samam624/esp32-s3-pdm-audio-recorder/070926 Data/mic_damping_figures/04_spectra_grid.png

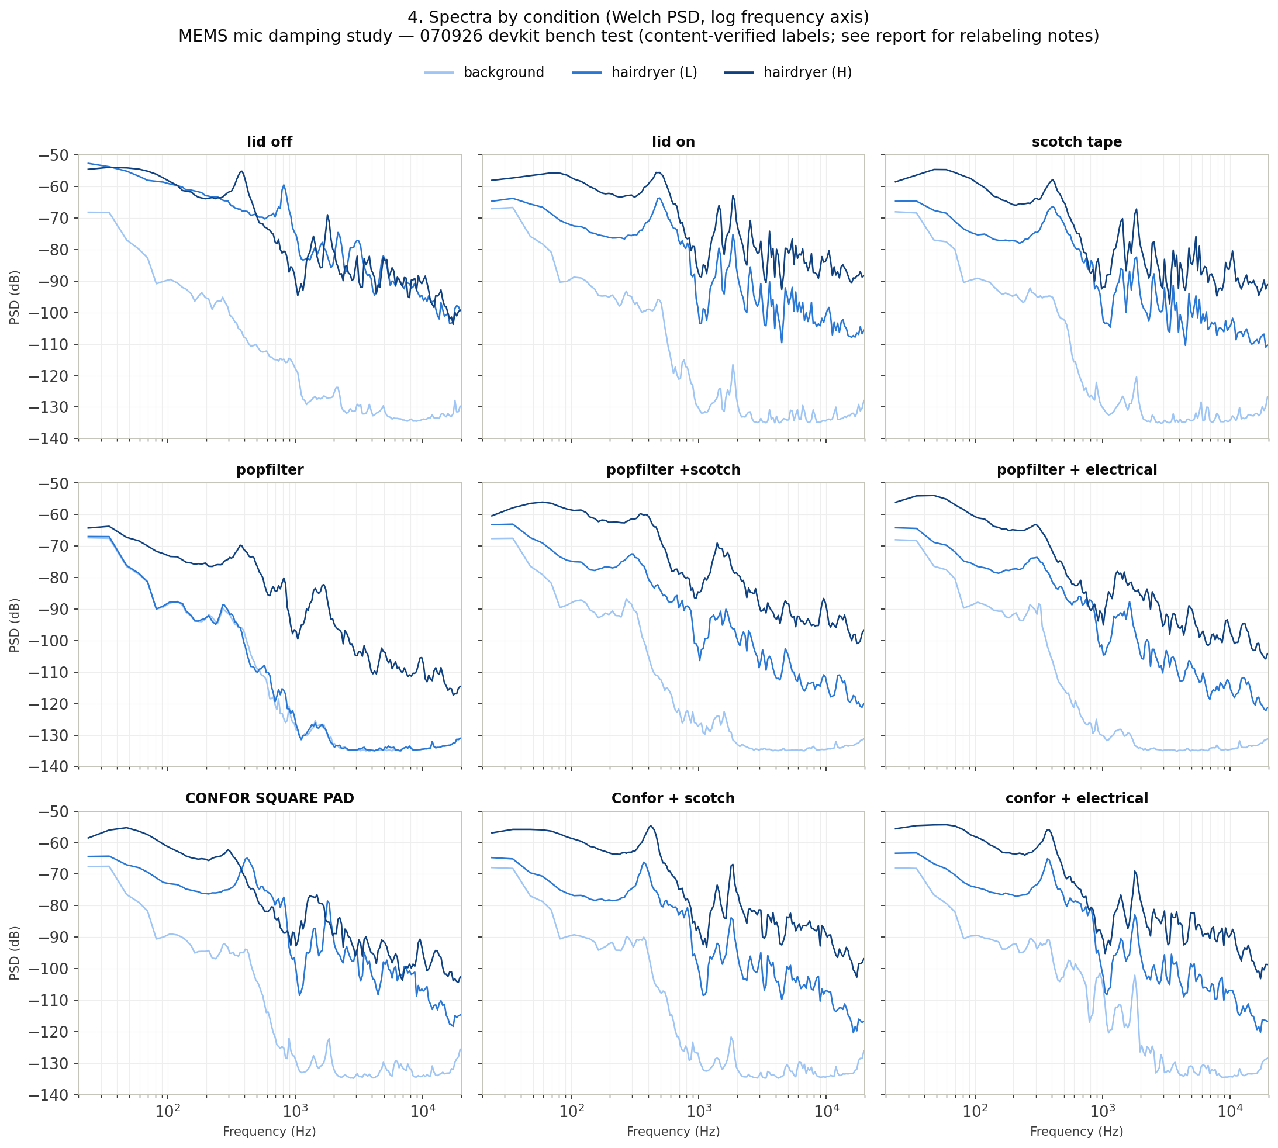
070926 Data/mic_damping_figures/04_spectra_grid.png
