samam624/esp32-s3-pdm-audio-recorder/070926 Data/mic_damping_figures/07_taped_vs_bare_diff.png

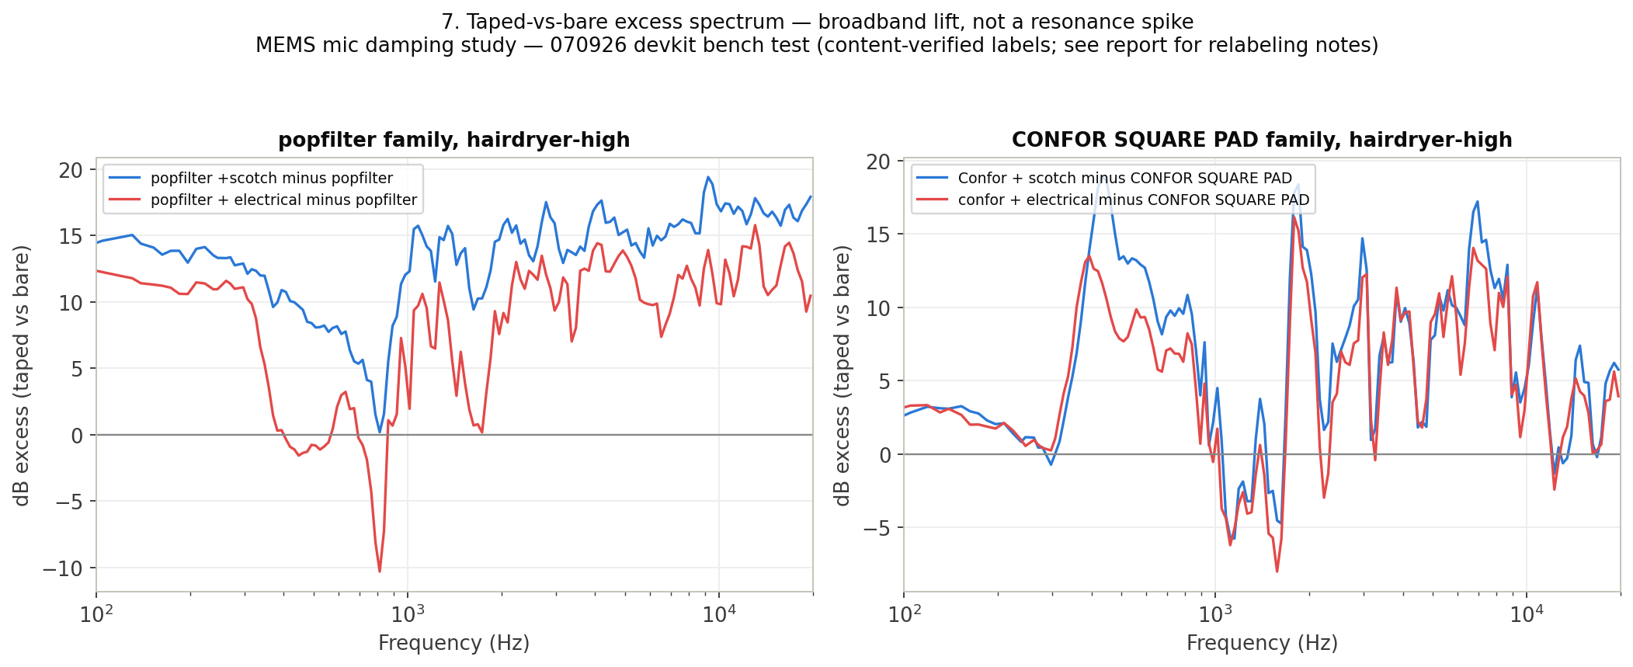
070926 Data/mic_damping_figures/07_taped_vs_bare_diff.png
