samam624/esp32-s3-pdm-audio-recorder/070926_Mic_Damping_Paper_Package/02_Figures/04_metrics_table.png

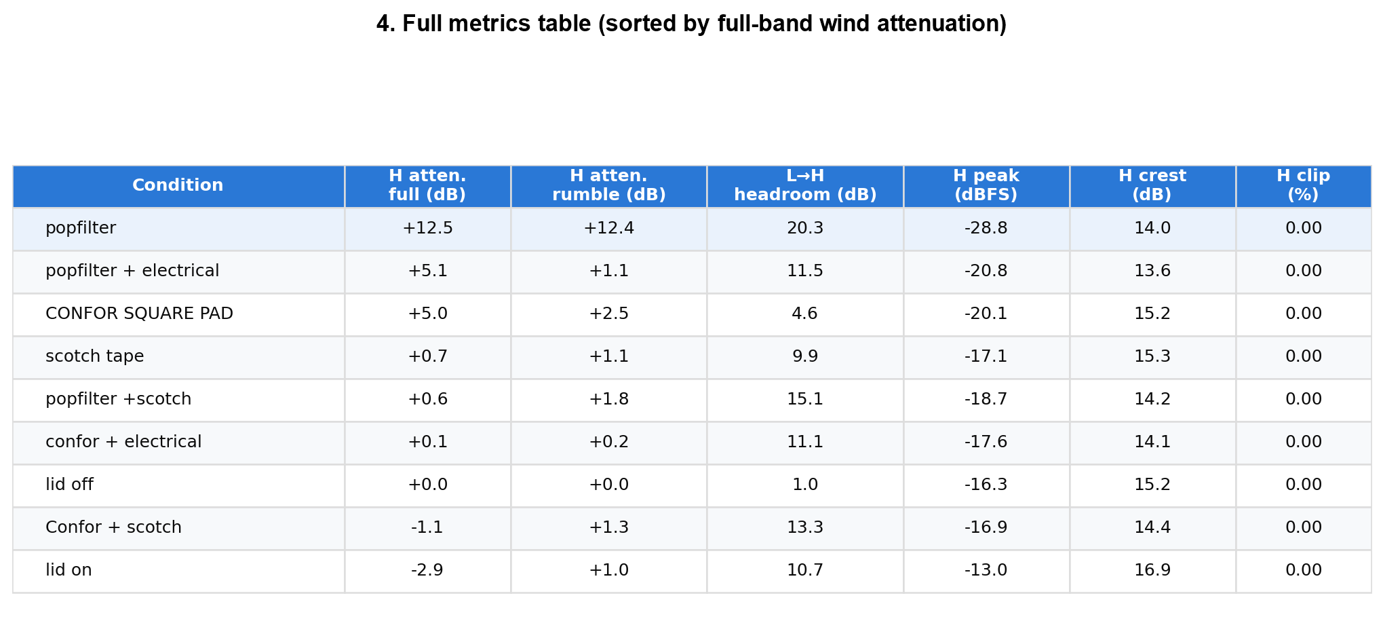
070926_Mic_Damping_Paper_Package/02_Figures/04_metrics_table.png
