samam624/esp32-s3-pdm-audio-recorder/MMSA V2/cad/wing_4415/output/reference/wing_ports.png

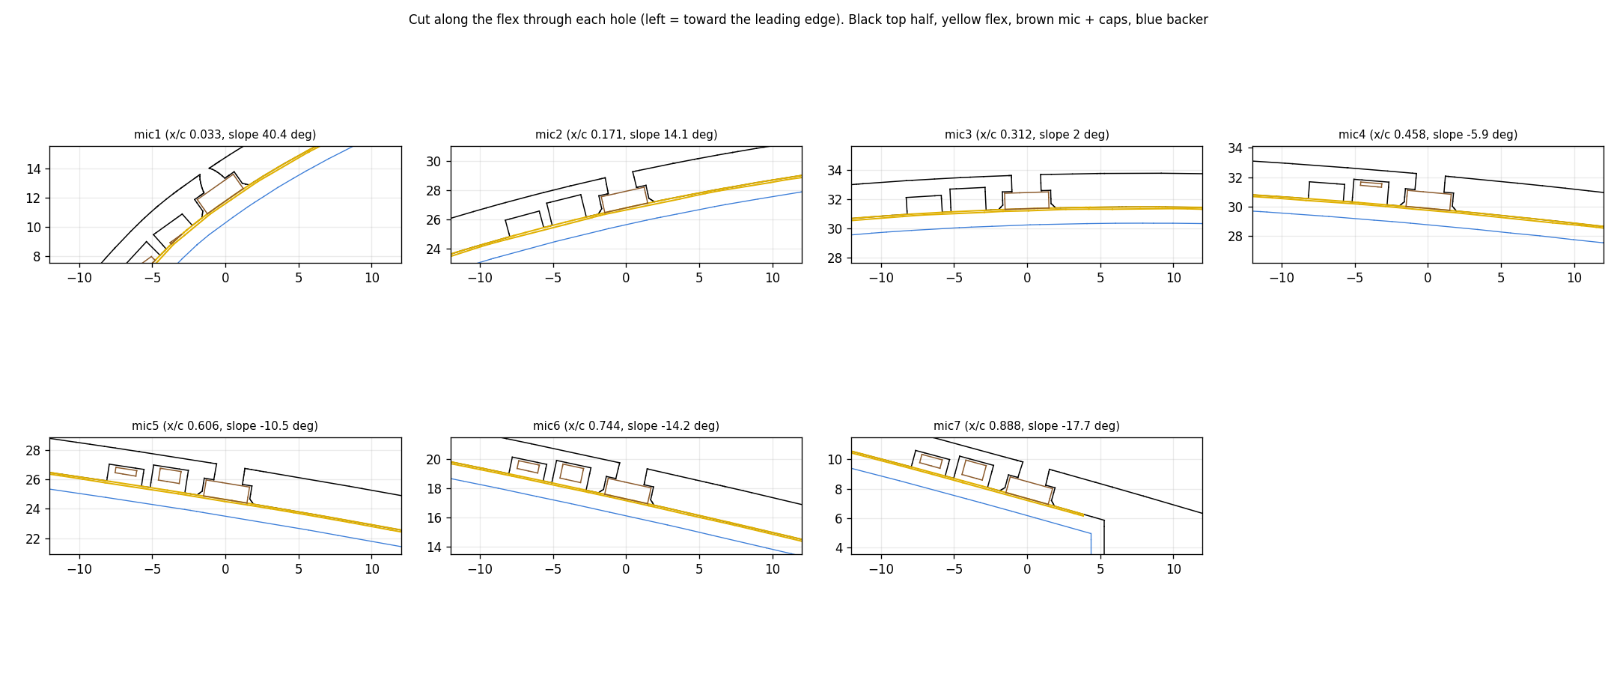
MMSA V2/cad/wing_4415/output/reference/wing_ports.png
