samam624/esp32-s3-pdm-audio-recorder/MMSA V2/data/102926/analysis/band_compare/paper_metrics_broadband.png

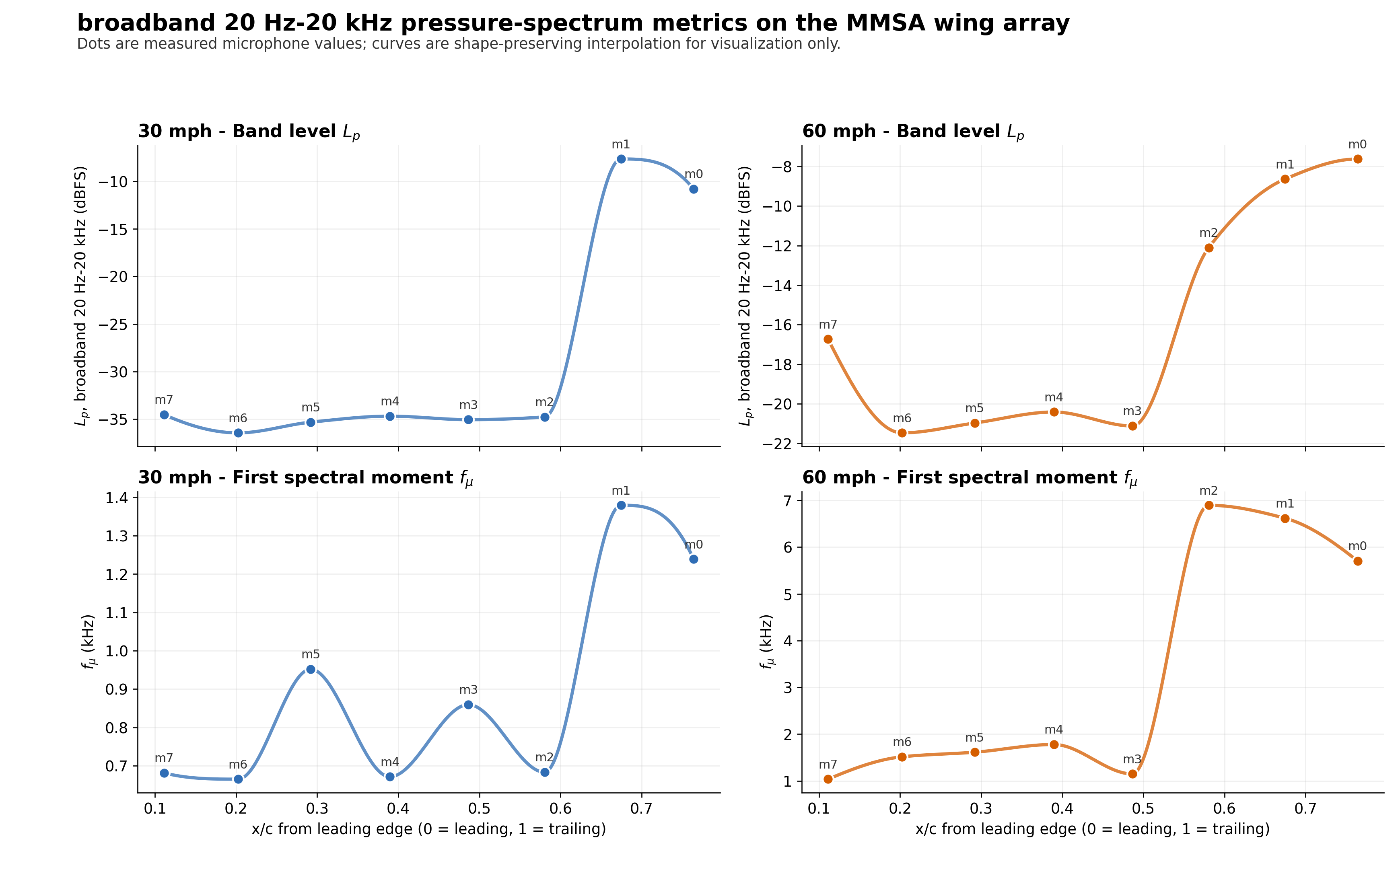
MMSA V2/data/102926/analysis/band_compare/paper_metrics_broadband.png
