samam624/esp32-s3-pdm-audio-recorder/MMSA V2/data/102926/analysis/baseline_spectrograms.png

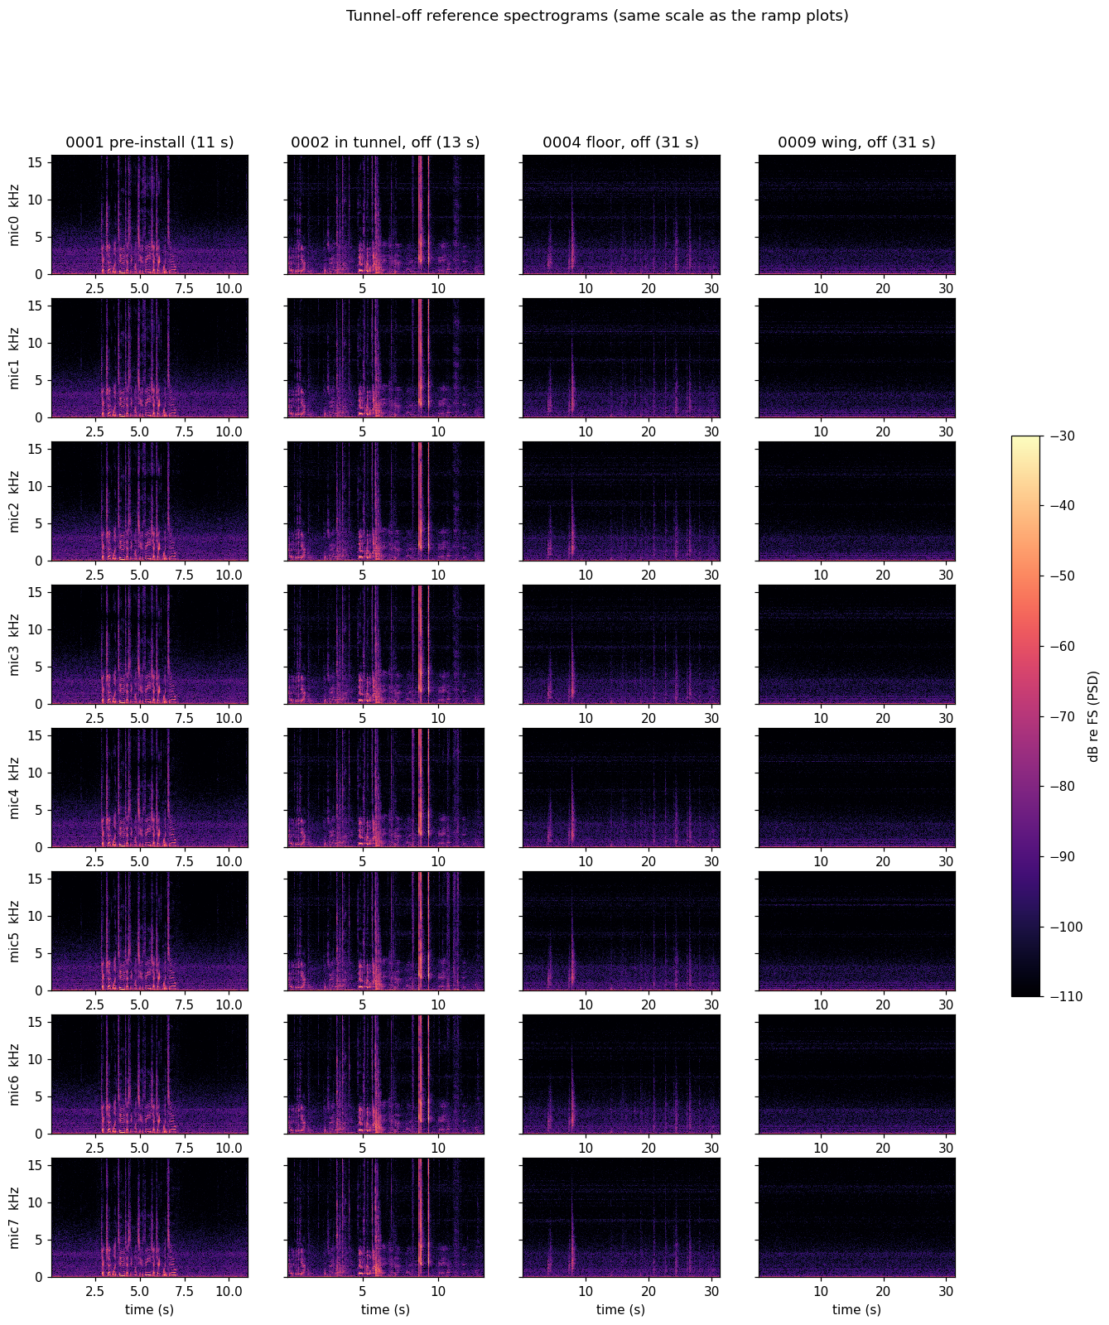
MMSA V2/data/102926/analysis/baseline_spectrograms.png
