samam624/esp32-s3-pdm-audio-recorder/MMSA V2/data/102926/analysis/flow_array_overlay_60mph.png

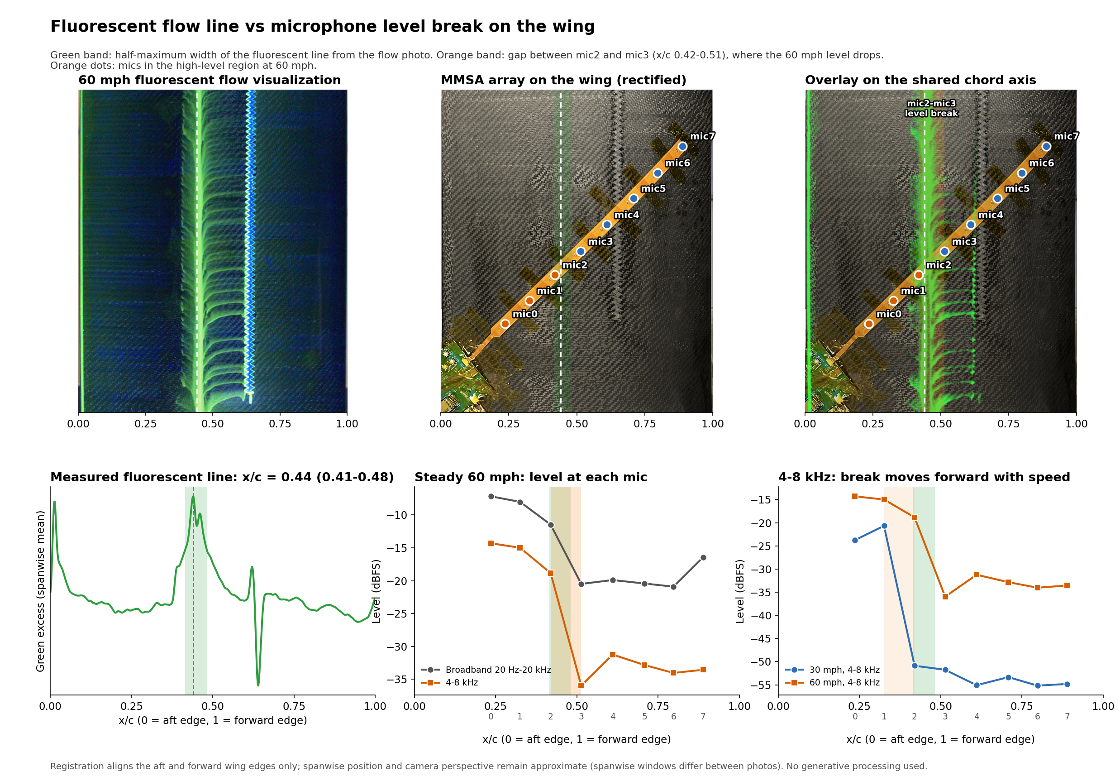
MMSA V2/data/102926/analysis/flow_array_overlay_60mph.png
