samam624/esp32-s3-pdm-audio-recorder/MMSA V2/data/102926/analysis/paper_methods/paper_metrics_spatial.png

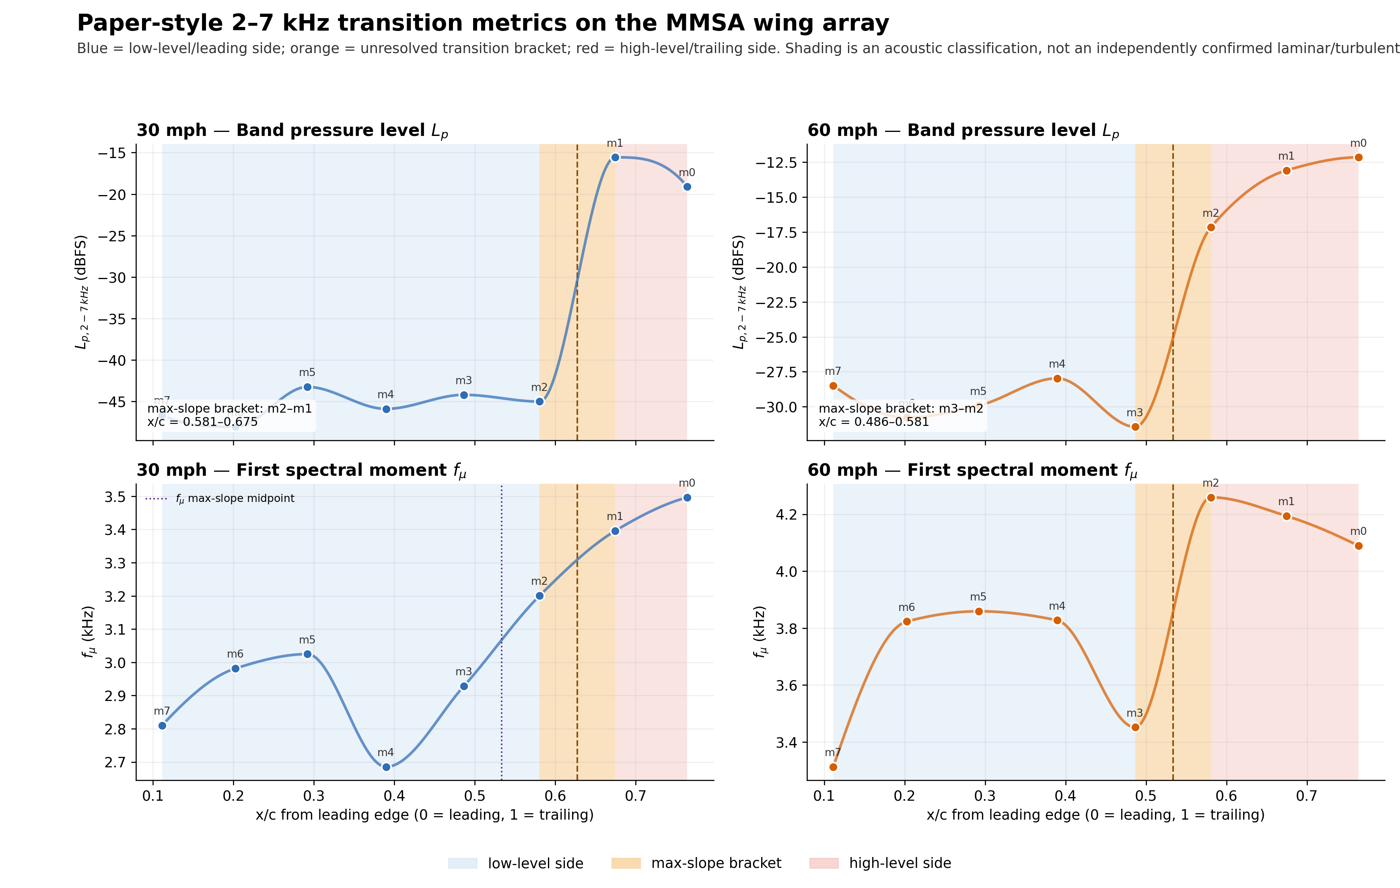
MMSA V2/data/102926/analysis/paper_methods/paper_metrics_spatial.png
