samam624/esp32-s3-pdm-audio-recorder/MMSA V2/data/102926/analysis/session_overview.png

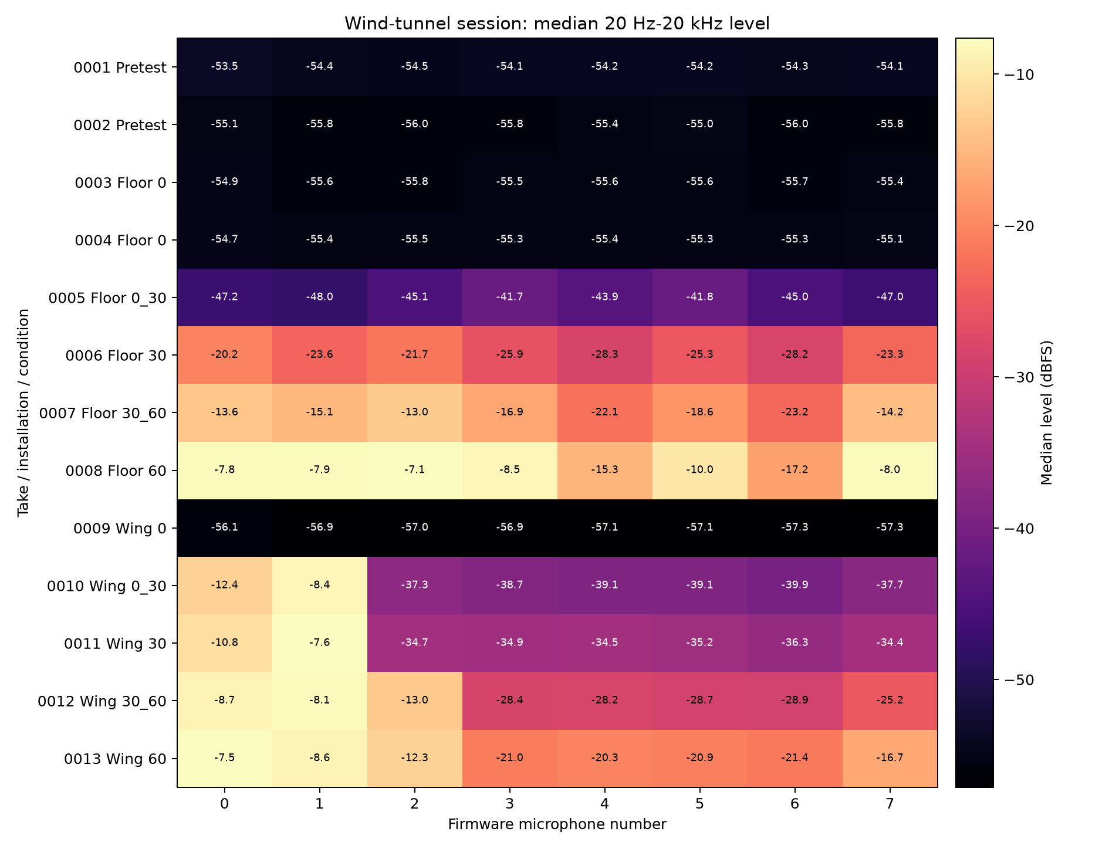
MMSA V2/data/102926/analysis/session_overview.png
