samam624/esp32-s3-pdm-audio-recorder/MMSA V2/data/102926/analysis/wing_peak_zone.png

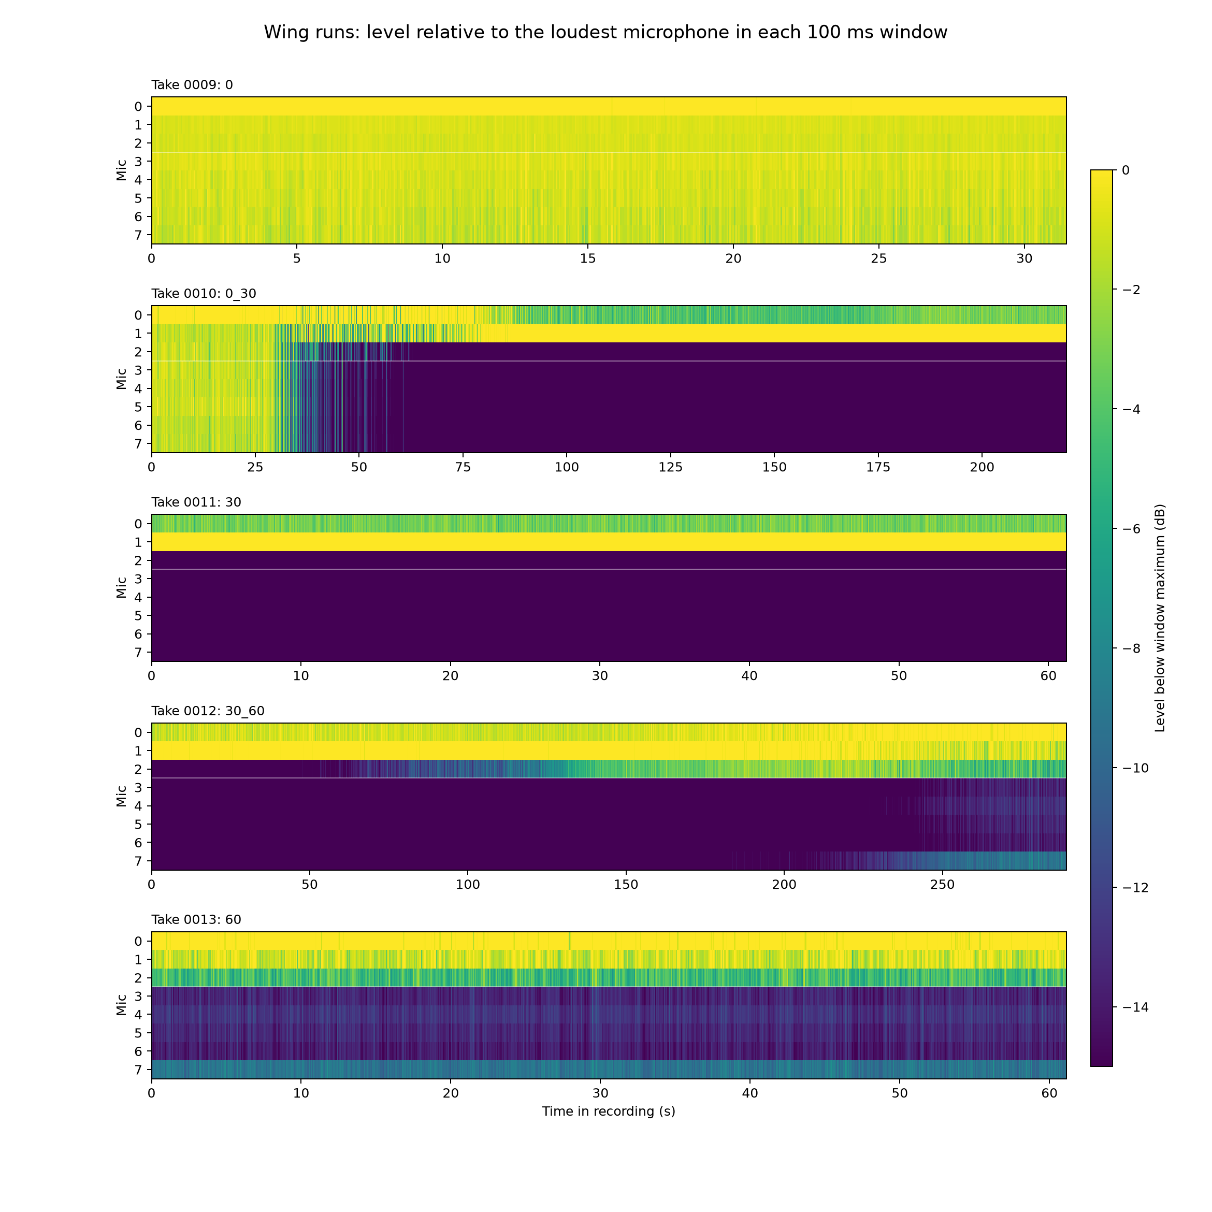
MMSA V2/data/102926/analysis/wing_peak_zone.png
