samam624/esp32-s3-pdm-audio-recorder/MMSA V2/data/102926/source_photos/flow_60mph.jpg

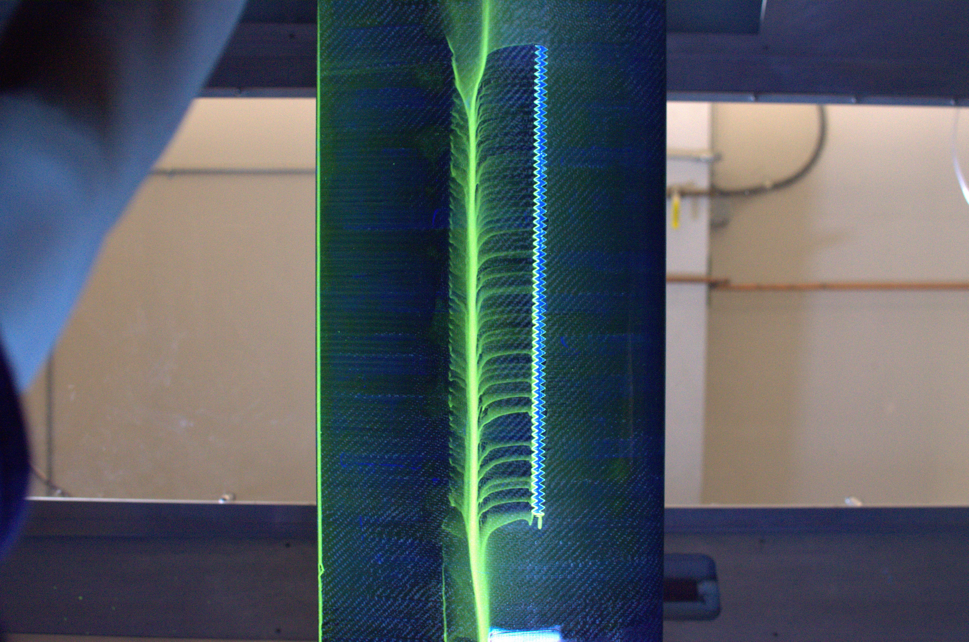
MMSA V2/data/102926/source_photos/flow_60mph.jpg
