samam624/esp32-s3-pdm-audio-recorder/MMSA V2/data/batlog/2026-10-26_charge/batlog_2026-10-26_charge.png

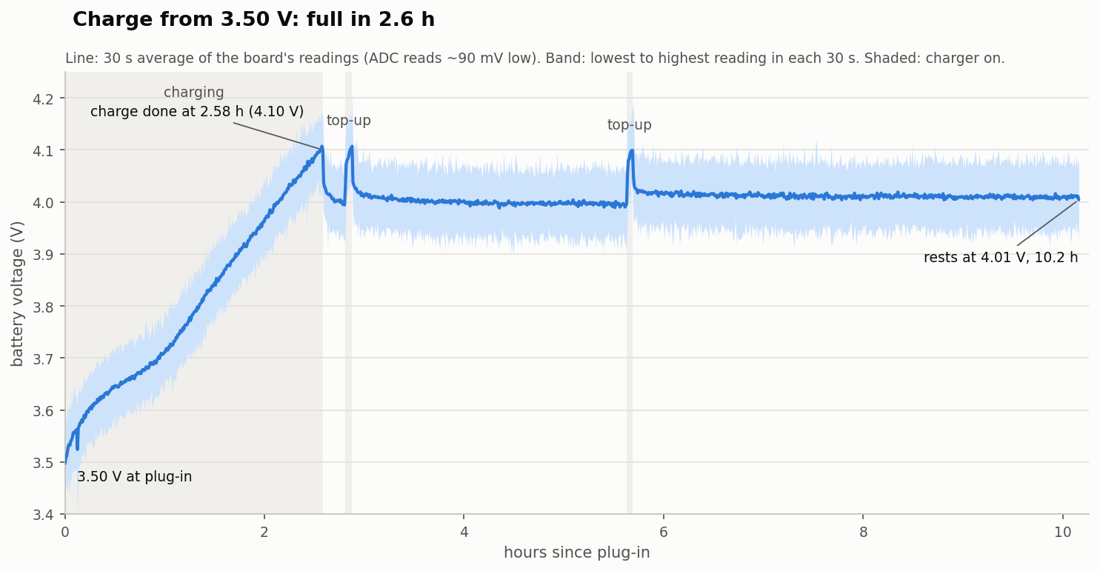
MMSA V2/data/batlog/2026-10-26_charge/batlog_2026-10-26_charge.png
