samam624/esp32-s3-pdm-audio-recorder/MMSA V2/data/power/2026-10-24/power_2026-10-24_vs_baseline.png

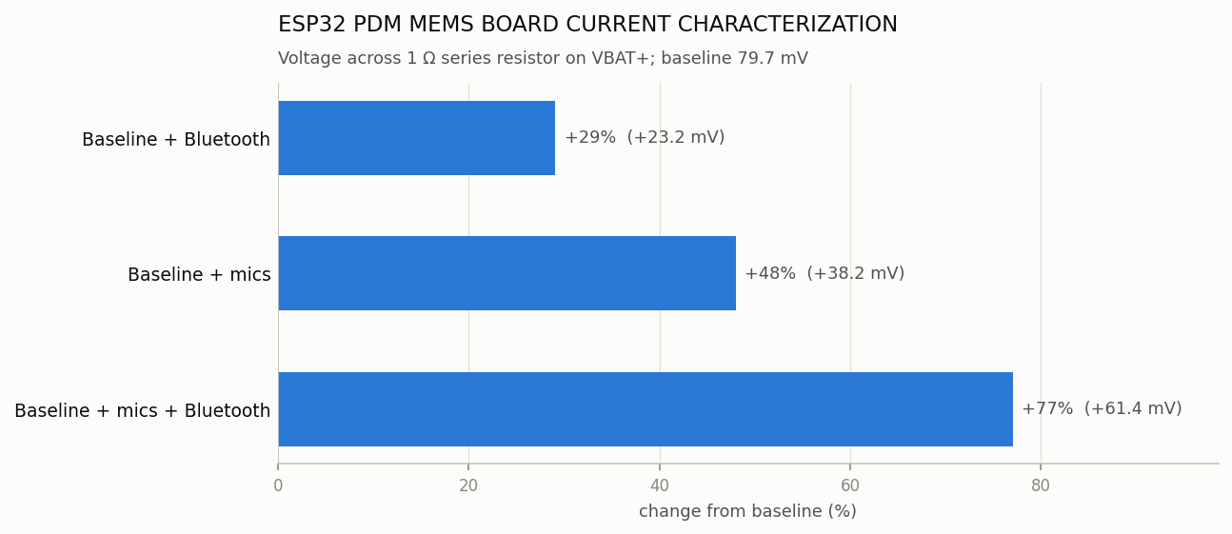
MMSA V2/data/power/2026-10-24/power_2026-10-24_vs_baseline.png
