samam624/esp32-s3-pdm-audio-recorder/MMSA V2/data/visualizations/window_comparison/gcc_100ms.png

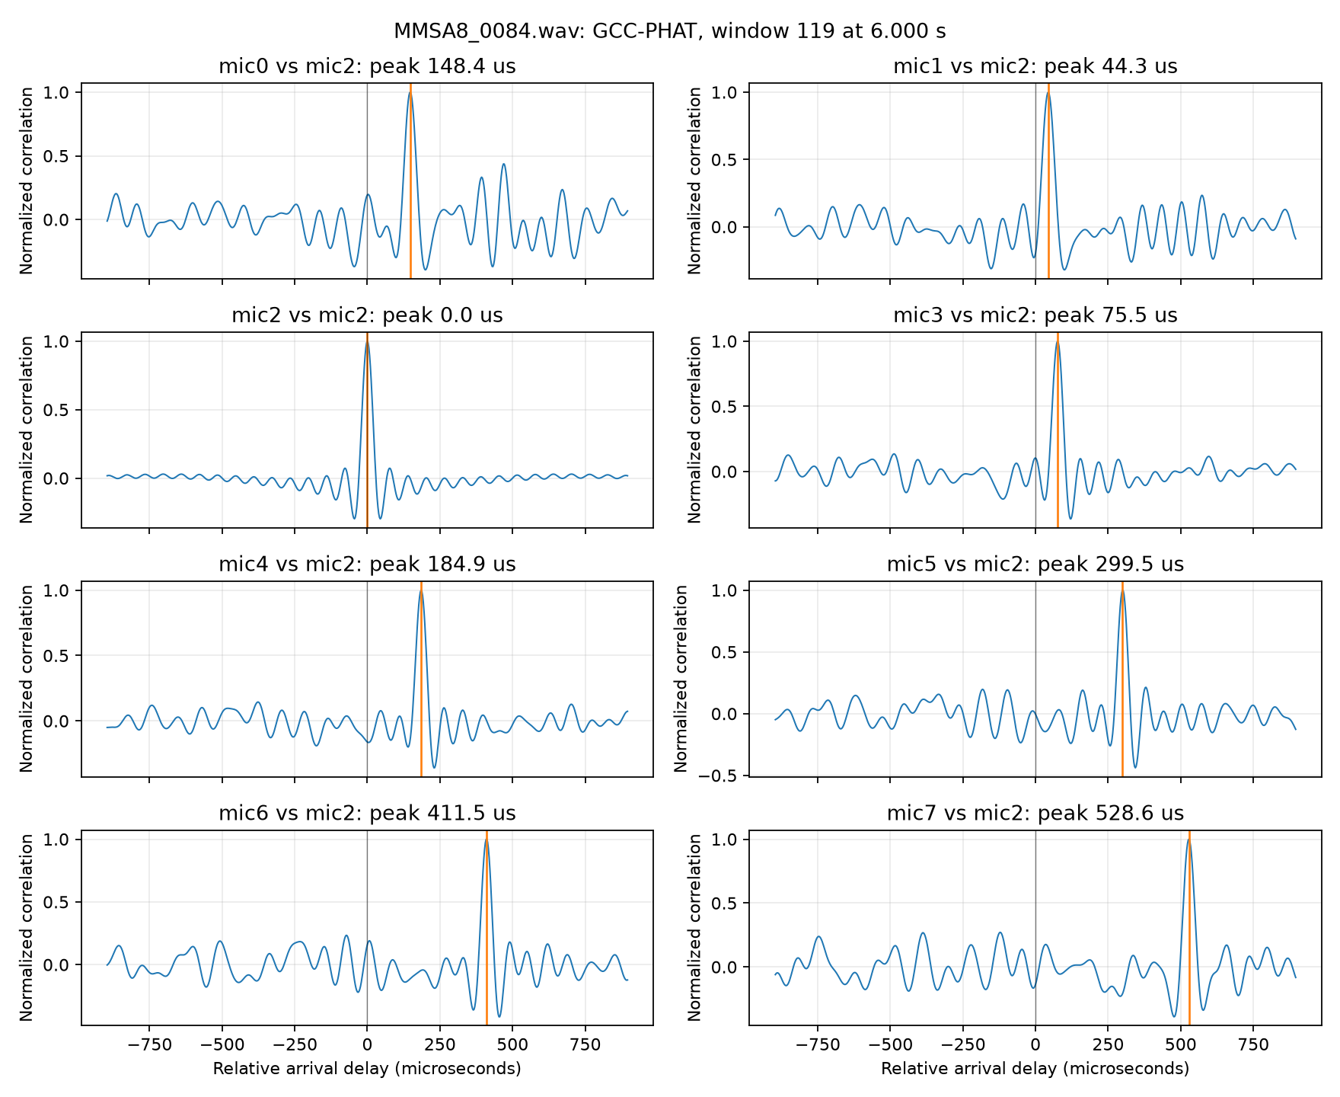
MMSA V2/data/visualizations/window_comparison/gcc_100ms.png
