samam624/esp32-s3-pdm-audio-recorder/MMSA V2/reference/port_filter_model.png

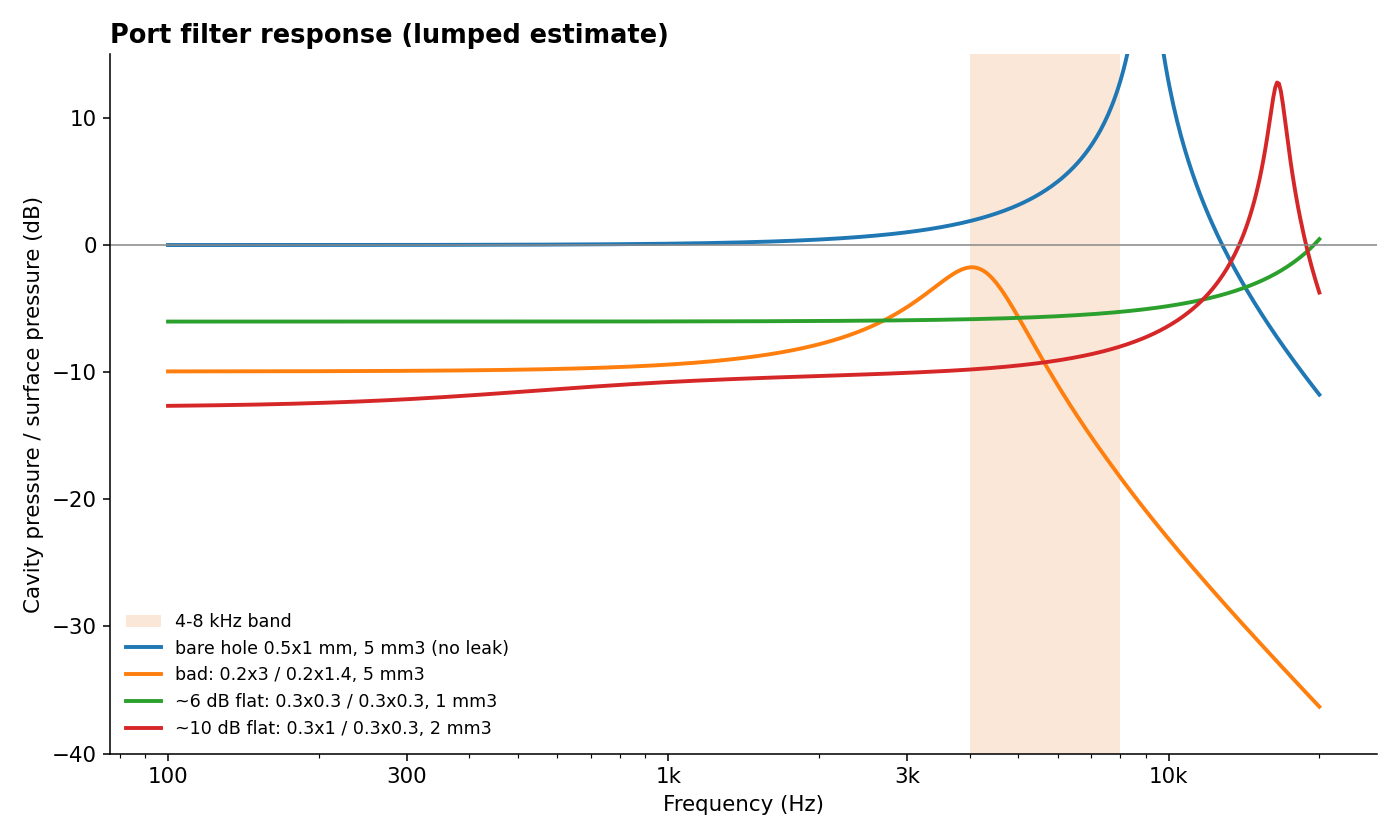
MMSA V2/reference/port_filter_model.png
