samam624/esp32-s3-pdm-audio-recorder/MMSA V2/reference/schematics/ESP32_SD_section.png

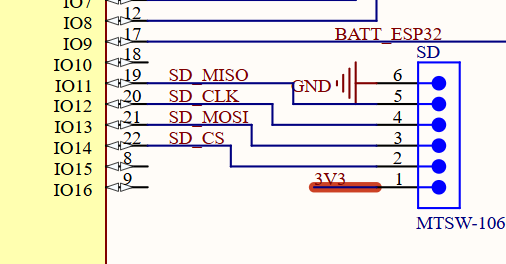
MMSA V2/reference/schematics/ESP32_SD_section.png
