samam624/esp32-s3-pdm-audio-recorder/MMSA V2/reference/schematics/FPC_connector_main_board.png

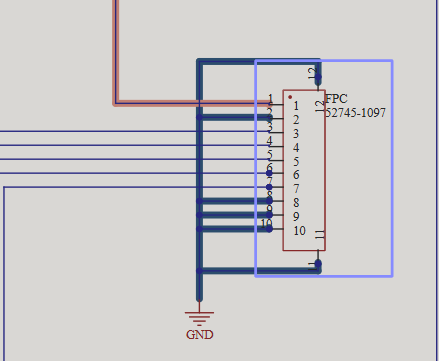
MMSA V2/reference/schematics/FPC_connector_main_board.png
