samam624/esp32-s3-pdm-audio-recorder/MMSA V2/reference/netlist/MMSA_V2_BOM_altium.csv

Line # | Name | Description | Designator | Revision ID | Revision State | Revision Status | Quantity | Manufacturer 1 | Manufacturer Part Number 1 | Manufacturer Lifecycle 1 | Supplier 1 | Supplier Part Number 1 | Supplier Unit Price 1 | Supplier Subtotal 1
 | B3F-1000 | Tactile Switch, SPST-NO, 0.05 A, 5 to 24 V, -25 to 70 degC, 4-Pin THD, RoHS, Bulk | BOOT, REC, RES | CMP-1677-00002-1 | Released | Up to date | 3 | Omron | B3F-1000 | Volume Production | Arrow Electronics | B3F-1000 | 0.2552 | 0.7656
 | CC0603MRX7R5BB475 | CAP CER 4.7UF 6.3V X7R 0603 | C1, C2 | CMP-03422-001038-2 | New From Design | Up to date | 2 | Yageo Group | CC0603MRX7R5BB475 | Volume Production | Mouser | 603-CC0603MRX75BB475 | 0.53 | 1.06
 | C0603C104Z3VACTU | CAP CER 0.1UF 25V Y5V 0603 | C3, C6, C12, C14, C15, C16, C17 | CMP-2006-03069-2 | Released | Up to date | 7 | Yageo Group | C0603C104Z3VACTU | Volume Production | RS (Formerly Allied Electronics) | C0603C104Z3VACTU | 0.02 | 0.14
 | CC0603KRX5R6BB106 | CAP CER 10UF 10V X5R 0603 | C4, C5, C7, C10, C11, C13 | CMP-03422-001507-1 | New From Design | Up to date | 6 | Yageo Group | CC0603KRX5R6BB106 | Volume Production | Newark | CC0603KRX5R6BB106 | 0.094 | 0.94
 | LTST-C190KGKT | LED GREEN CLEAR CHIP SMD | D1, D4 | CMP-2000-05197-2 | New From Design | Up to date | 2 | Diodes Inc. | LTST-C190KGKT | Volume Production | DigiKey | 160-1435-6-ND | 0.15 | 0.3
 | LTST-C190KFKT | LED ORANGE CLEAR CHIP SMD | D2 | CMP-1674-00008-9 | Released | Up to date | 1 | Diodes Inc. | LTST-C190KFKT | Volume Production | Arrow Electronics | LTST-C190KFKT | 0.0239 | 0.0478
 | LTST-C191TBKT | LED BLUE CLEAR CHIP SMD | D3 | CMP-22017-000008-1 | New From Design | Up to date | 1 | Diodes Inc. | LTST-C191TBKT | Volume Production | DigiKey | 160-1647-6-ND | 0.25 | 0.25
 | LTST-C190KRKT | LED RED CLEAR CHIP SMD | D5, D6 | CMP-1674-00011-2 | New From Design | Up to date | 2 | Diodes Inc. | LTST-C190KRKT | Volume Production | DigiKey | 160-1436-1-ND | 0.14 | 0.28
 | Test Point | Test Point | D-, D+ | CMP-00000-2 | Draft | Up to date | 2
 | USBLC6-2P6 | 17V Clamp 5A (8/20Âµs) Ipp Tvs Diode Surface Mount SOT-666 | ESD | CMP-025-000000-1 | Draft | Up to date | 1
 | ESP32-S3-WROOM-1-N8R8 | Bluetooth, WiFi 802.11b/g/n, Bluetooth v5.0 Transceiver Module 2.4GHz PCB Trace Surface Mount | ESP32_MC | CMP-009-000000-1 | Draft | Up to date | 1
 | MPZ1608D600BTD25 | Power line Ferrite Bead 60O @ 100MHz 1.2A DCR 0.1O AEC-Q200 SMD 0603 | FB | CMP-08257-000402-1 | New From Design | Up to date | 1 | TDK | MPZ1608D600BTD25 | Volume Production | Mouser | 810-MPZ1608D600BTD25 | 0.1 | 0.1
 | 687110183622 | Conn FFC/FPC Connector SKT 10 POS 0.5mm Solder RA SMD T/R | FPC | CMP-1502-01591-3 | Released | Up to date | 1 | Wurth Elektronik | 687110183622 | Volume Production | Mouser | 710-687110183622 | 1.84 | 1.84
 | TPS7A2018PDBVR | IC REG LINEAR 1.8V 300MA SOT23-5 | LDO_1V8 | CMP-04917-000324-1 | New From Design | Up to date | 1 | Texas Instruments | TPS7A2018PDBVR | Volume Production | DigiKey | 296-TPS7A2018PDBVRDKR-ND | 0.37 | 0.37
 | AP2112K-3.3TRG1 | IC REG LINEAR 3.3V 600MA SOT25 | LDO_3V3 | CMP-12756-000035-1 | New From Design | Up to date | 1 | Diodes Inc. | AP2112K-3.3TRG1 | Volume Production | Mouser | 621-AP2112K-3.3TRG1 | 0.26 | 0.26
 | S2B-PH-K-S(LF)(SN) | Male Header, Pitch 2 mm, 1 x 2 Position, Height 4.8 mm, Tail Length 3.4 mm, -25 to 85 degC, RoHS, Bulk | LiPo | CMP-1755-00004-1 | Released | Up to date | 1 | JST | S2B-PH-K-S(LF)(SN) | Volume Production | Mouser | 306-S2BPHKSLFSNPP | 0.11 | 0.11
 | RC0603FR-132KL |  | R1 | CMP-2000-04213-1 | Released | Up to date | 1 | Yageo Group | RC0603FR-132KL | Volume Production | Mouser | 603-RC0603FR-132KL | 0.1 | 0.1
 | CPF0603D10KE | RES SMD 10KO 0.5% 1/16W 0603 | R2, R3, R9, R11, R13 | CMP-03211-003506-1 | New From Design | Up to date | 5 | TE Connectivity / AMP | 2-1614882-6 | Volume Production | Mouser | 279-CPF0603D10KE | 0.1 | 0.5
 | RC0603JR-13470RL |  | R4, R5, R6, R17, R18, R19 | CMP-2000-04326-1 | Released | Up to date | 6 | Yageo Group | RC0603JR-13470RL | Volume Production | Mouser | 603-RC0603JR-13470RL | 0.012 | 0.12
 | CRCW06035K10JNEA | RES Thick Film, 5.1kO, 5%, 0.1W, 200ppm/°C, 0603 | R7, R8 | CMP-2000-03480-2 | New From Design | Up to date | 2 | Vishay | CRCW06035K10JNEA | Volume Production | Arrow Electronics | CRCW06035K10JNEA | 0.0009 | 0.0018
 | RC0603JR-0722RL | RES SMD 22 OHM 5% 1/10W 0603 | R10, R15, R16 | CMP-03412-037819-1 | New From Design | Up to date | 3 | Yageo Group | RC0603JR-0722RL | Volume Production | Mouser | 603-RC0603JR-0722RL | 0.012 | 0.12
 | CRGP0603F100K | CRGP 0603 100K 1% | R12, R14 | CMP-03211-000885-1 | New From Design | Up to date | 2 | TE Connectivity | CRGP0603F100K | Volume Production | Newark | CRGP0603F100K | 0.173 | 0.346
 | MTSW-106-09-T-S-540 | Modified .025" SQ Post Header, Through-hole, Vertical, -55 to 105 degC, 2.54 mm Pitch, 6-Pin, Male, RoHS | SD | CMP-1024-00125-1 | Released | Up to date | 1 | Samtec | MTSW-106-09-T-S-540 | Volume Production | Avnet | MTSW-106-09-T-S-540 | 0.396 | 0.396
 | MCP73871T-4CCI/ML | Stand-Alone System Load Sharing and Li-Ion/Li-Polymer Battery Charge Management Controller, 4.4V, 20-Pin QFN, Industrial Temperature, Tape and Reel | USB_IC | CMP-0133-00010-1 | Released | Up to date | 1 | Microchip | MCP73871T-4CCI/ML | Volume Production | DigiKey | MCP73871T-4CCI/MLCT-ND | 2.41 | 2.41
 | 10155435-00011LF |  | USBC | CMP-017-000000-1 | Draft | Up to date | 1
