samam624/esp32-s3-pdm-audio-recorder/MMSA V2/reference/netlist/MMSA_V2_BOM_JLCPCB.csv

Comment | Designator | Footprint | LCSC Part #
MCP73871T-2CCI/ML | Charging IC | QFN-20-EP(4x4) | C511310
B3F-1000 | BOOT,REC,RES | THD 4-Pin | C93157
CC0603KRX7R9BB104 | C3,C6,C12,C14,C15,C16,C17 | 0603 | C14663
CL10A106KP8NNNC | C4,C5,C7,C10,C11,C13 | 0603 | C19702
CL10A475KA8NQNC | C1,C2 | 0603 | C69335
LTST-C190KGKT | D1,D3,D4 | 0603 | C125094
LTST-C190KRKT | D2,D5,D6 | 0603 | C94869
USBLC6-2P6 | ESD1 | SOT-666-6 | C15999
ESP32-S3-WROOM-1-N8R8 | ESP32_MC | SMD,18x13mm | C2913201
MPZ1608D600BTD25 | FB | 0603 | C404683
687110183622 | FPC | FPC SMT ZIF, 10-pos, 0.5mm pitch, Top Contact
TPS7A2018PDBVR | LDO_1V8 | SOT-23-5 | C963430
AP2112K-3.3TRG1 | LDO_3V3 | SOT-25 | C51118
S2B-PH-K-S(LF)(SN) | LiPo | THD 2-Pin Right Angle | C173752
0603WAF2001T5E | R1 | 0603 | C269690
0603WAF1002T5E | R2,R3,R9,R11,R13 | 0603 | C25804
RC0603FR-07470RL | R4,R5,R6,R17,R18,R19 | 0603 | C114669
0603WAF5101T5E | R7,R8 | 0603 | C23186
RC0603FR-0722RL | R10,R15,R16 | 0603 | C107701
0603 100K 1% | R12,R14 | 0603 | C2889376
10155435-00011LF | USBC | USB-C SMD Receptacle
