samam624/esp32-s3-pdm-audio-recorder/MMSA V2/cad/airfoil_testbed/output/MMSA_testbed_v1_print.3mf

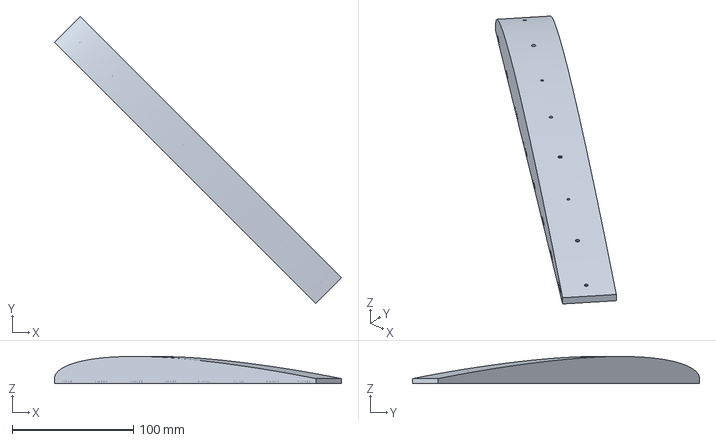
[picture p66: CAD file, 2026-11-03]
MMSA V2/cad/airfoil_testbed/output/MMSA_testbed_v1_print.3mf
236.7 x 236.7 x 22.3 mm
