samam624/esp32-s3-pdm-audio-recorder/MMSA V2/cad/airfoil_testbed/output/reference/MMSA_testbed_v1_backer_only.3mf

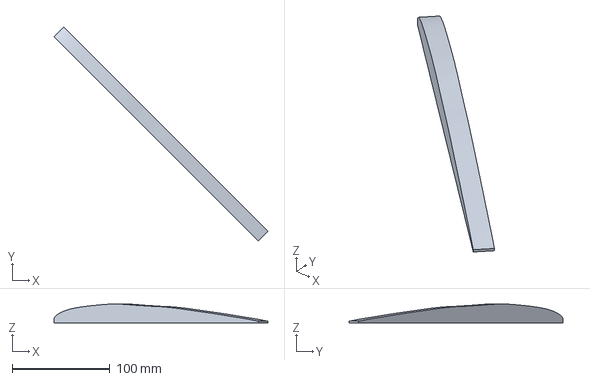
[picture p67: CAD file, 2026-11-03]
MMSA V2/cad/airfoil_testbed/output/reference/MMSA_testbed_v1_backer_only.3mf
218.8 x 218.8 x 19.2 mm
