samam624/esp32-s3-pdm-audio-recorder/MMSA V2/cad/airfoil_testbed_0012/output/reference/backer.stl

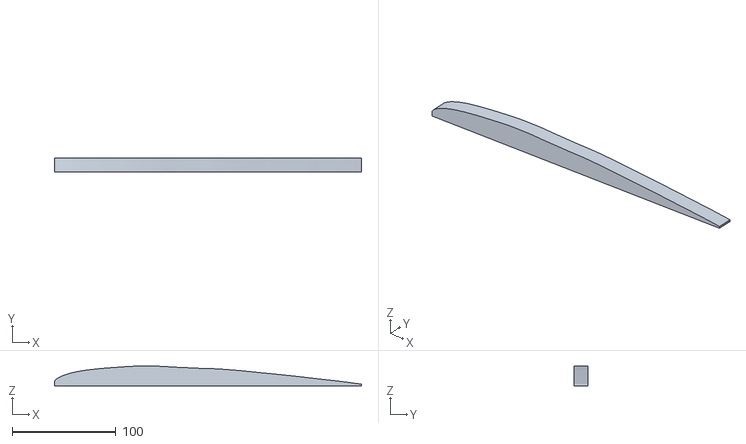
[picture p68: CAD file, 2026-11-03]
MMSA V2/cad/airfoil_testbed_0012/output/reference/backer.stl
295.6 x 13.8 x 19.2
