samam624/esp32-s3-pdm-audio-recorder/MMSA V2/cad/airfoil_testbed_4415/input/Air Foil NACA 4415 Small Slot.step

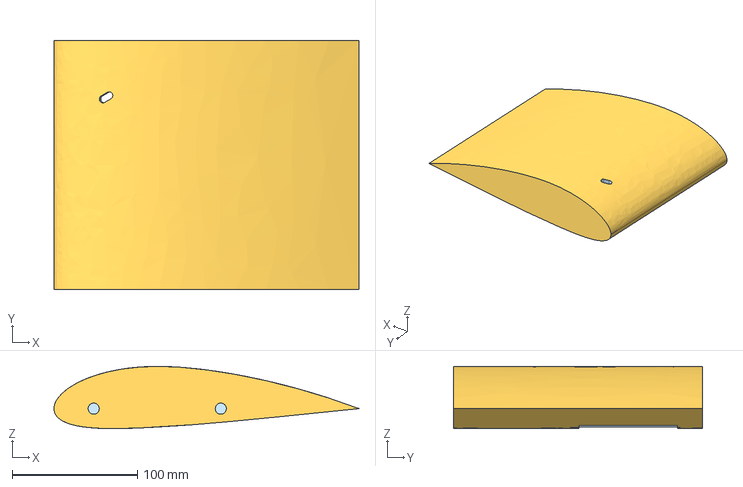
[picture p69: CAD file, 2026-11-03]
MMSA V2/cad/airfoil_testbed_4415/input/Air Foil NACA 4415 Small Slot.step
243.8 x 199.1 x 49.8 mm
