samam624/esp32-s3-pdm-audio-recorder/MMSA V2/cad/airfoil_testbed_4415/output/MMSA_testbed_4415_print.3mf

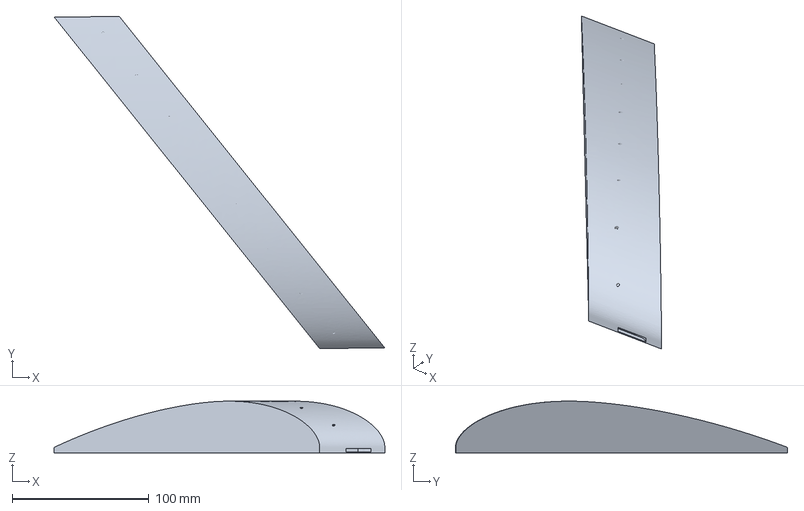
[picture p70: CAD file, 2026-11-03]
MMSA V2/cad/airfoil_testbed_4415/output/MMSA_testbed_4415_print.3mf
241.6 x 242.6 x 37.8 mm
