samam624/esp32-s3-pdm-audio-recorder/MMSA V2/cad/airfoil_testbed_4415/output/reference/MMSA_testbed_4415_fitcheck.step

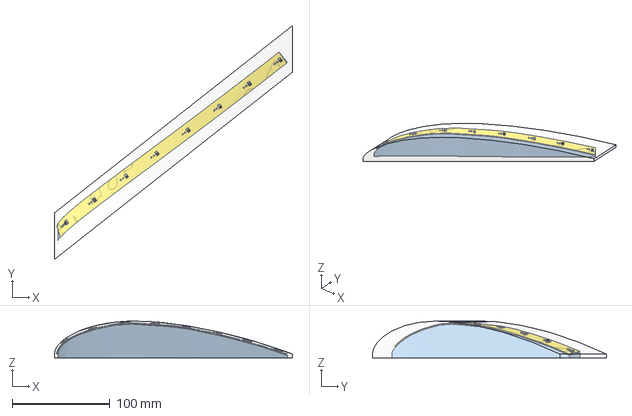
[picture p71: CAD file, 2026-11-03]
MMSA V2/cad/airfoil_testbed_4415/output/reference/MMSA_testbed_4415_fitcheck.step
243.8 x 239.5 x 37.8 mm
