samam624/esp32-s3-pdm-audio-recorder/MMSA V2/cad/wing_4415/output/reference/MMSA_wing_4415_fitcheck.step

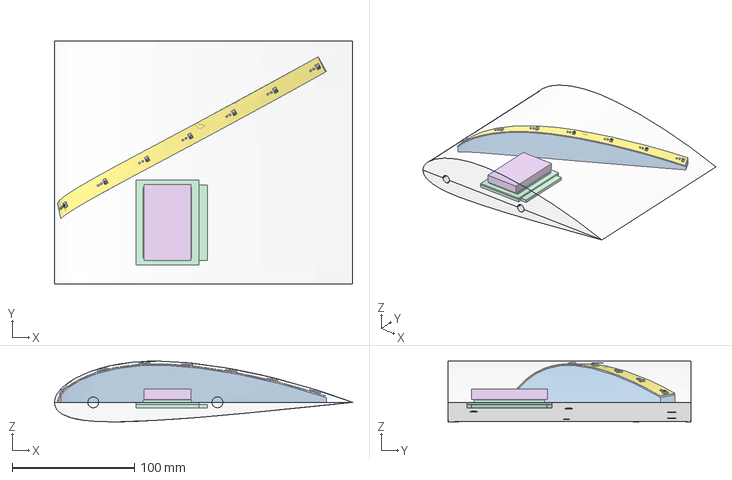
[picture p73: CAD file, 2026-11-03]
MMSA V2/cad/wing_4415/output/reference/MMSA_wing_4415_fitcheck.step
243.8 x 199.1 x 49.8 mm
