samam624/esp32-s3-pdm-audio-recorder/MMSA V2/cad/airfoil_testbed/output/MMSA_testbed_v1.step

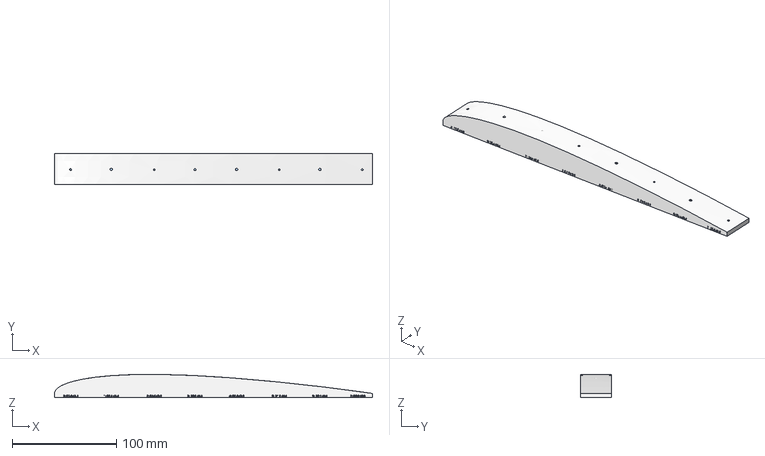
[picture p74: CAD file, 2026-11-03]
MMSA V2/cad/airfoil_testbed/output/MMSA_testbed_v1.step
304.8 x 30.0 x 22.3 mm
