samam624/esp32-s3-pdm-audio-recorder/MMSA V2/cad/airfoil_testbed/output/reference/block.stl

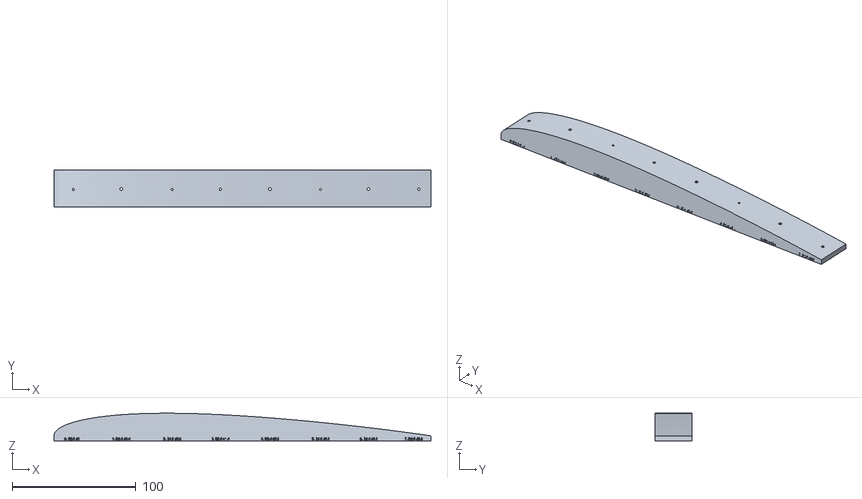
[picture p75: CAD file, 2026-11-03]
MMSA V2/cad/airfoil_testbed/output/reference/block.stl
304.8 x 30.0 x 22.3
