samam624/esp32-s3-pdm-audio-recorder/MMSA V2/cad/airfoil_testbed_0012/output/reference/MMSA_testbed_0012_fitcheck.step

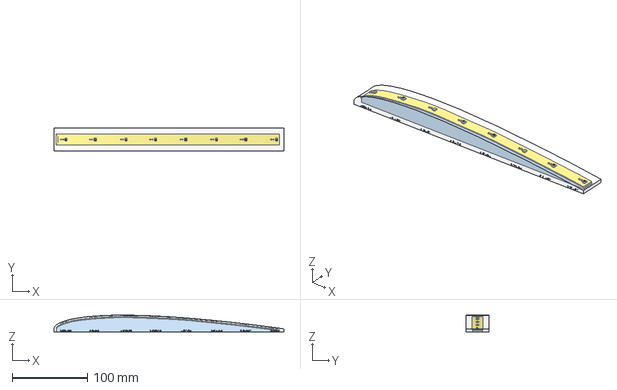
[picture p76: CAD file, 2026-11-03]
MMSA V2/cad/airfoil_testbed_0012/output/reference/MMSA_testbed_0012_fitcheck.step
304.8 x 30.0 x 22.3 mm
