samam624/esp32-s3-pdm-audio-recorder/MMSA V2/cad/airfoil_testbed_4415/output/reference/backer.stl

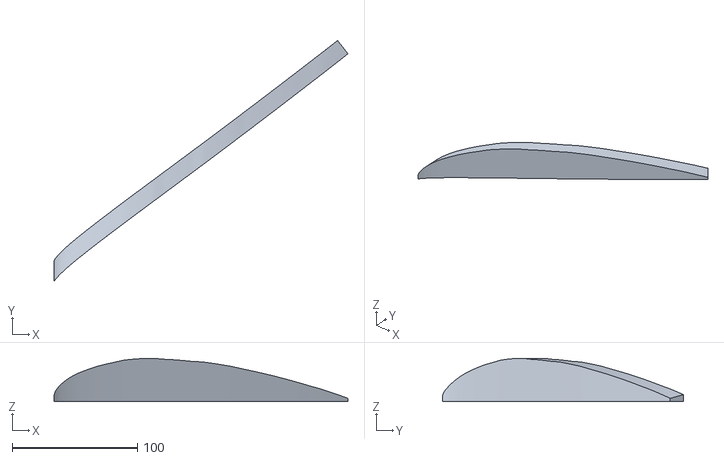
[picture p77: CAD file, 2026-11-03]
MMSA V2/cad/airfoil_testbed_4415/output/reference/backer.stl
235.1 x 192.7 x 34.7
