samam624/esp32-s3-pdm-audio-recorder/MMSA V2/cad/wing_4415/output/MMSA_wing_4415_top_print.3mf

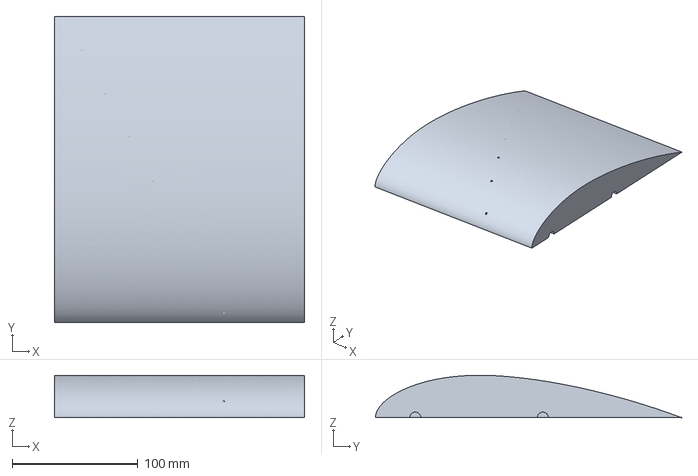
[picture p78: CAD file, 2026-11-03]
MMSA V2/cad/wing_4415/output/MMSA_wing_4415_top_print.3mf
199.1 x 243.8 x 33.8 mm
