samam624/esp32-s3-pdm-audio-recorder/MMSA V2/cad/wing_4415/output/reference/top.stl

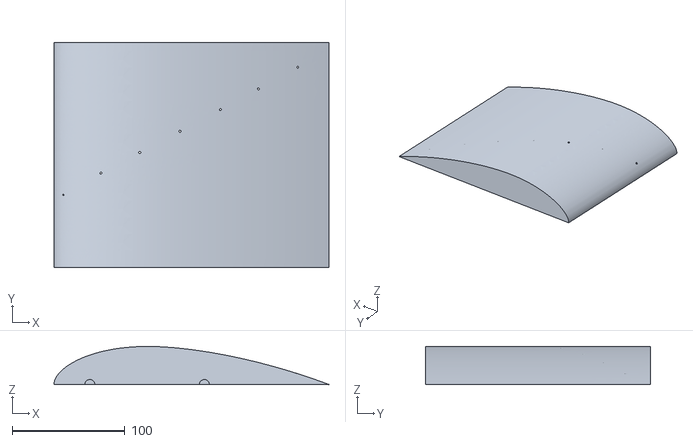
[picture p79: CAD file, 2026-11-03]
MMSA V2/cad/wing_4415/output/reference/top.stl
243.8 x 199.1 x 33.8
