samam624/esp32-s3-pdm-audio-recorder/MMSA V2/cad/airfoil_testbed_0012/output/reference/flex.stl

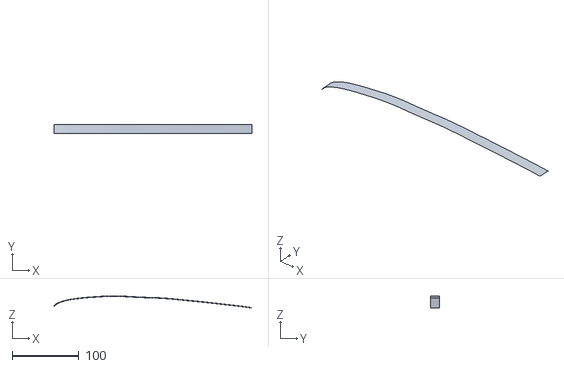
[picture p80: CAD file, 2026-11-03]
MMSA V2/cad/airfoil_testbed_0012/output/reference/flex.stl
296.2 x 14.0 x 17.5
