samam624/esp32-s3-pdm-audio-recorder/MMSA V2/cad/airfoil_testbed_4415/output/reference/flex.stl

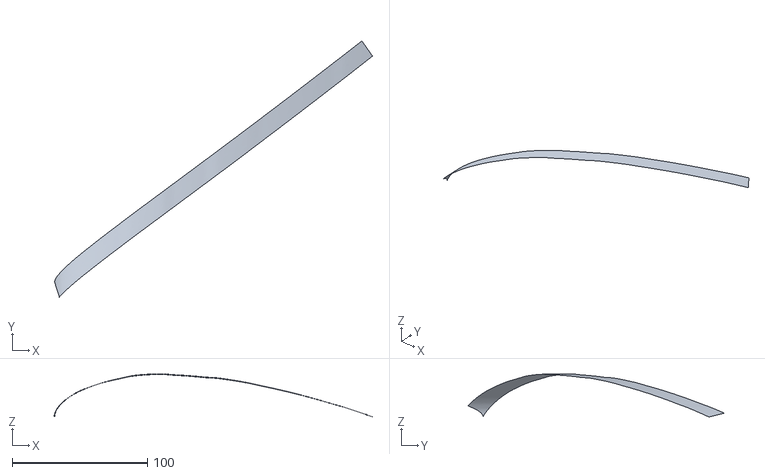
[picture p81: CAD file, 2026-11-03]
MMSA V2/cad/airfoil_testbed_4415/output/reference/flex.stl
235.5 x 189.7 x 31.8
