samam624/esp32-s3-pdm-audio-recorder/MMSA V2/cad/airfoil_testbed_0012/output/reference/parts.stl

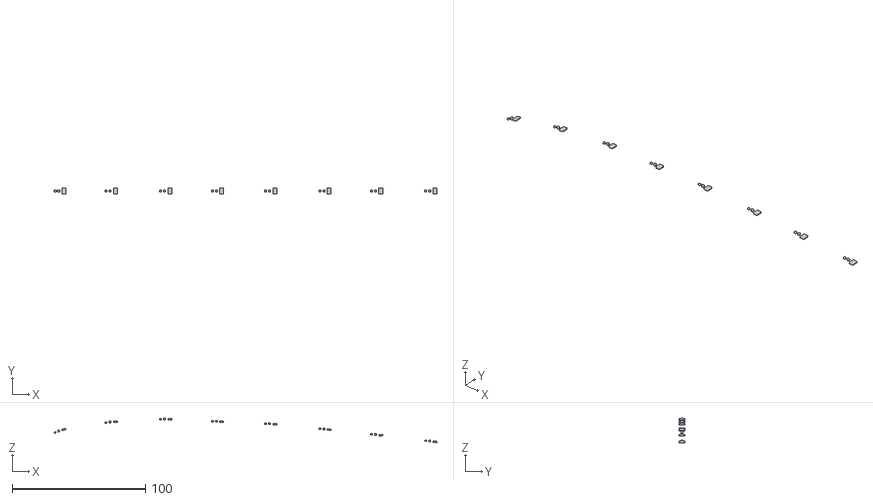
[picture p83: CAD file, 2026-11-03]
MMSA V2/cad/airfoil_testbed_0012/output/reference/parts.stl
287.9 x 4.28 x 18.5
