samam624/esp32-s3-pdm-audio-recorder/MMSA V2/cad/airfoil_testbed_4415/output/reference/parts.stl

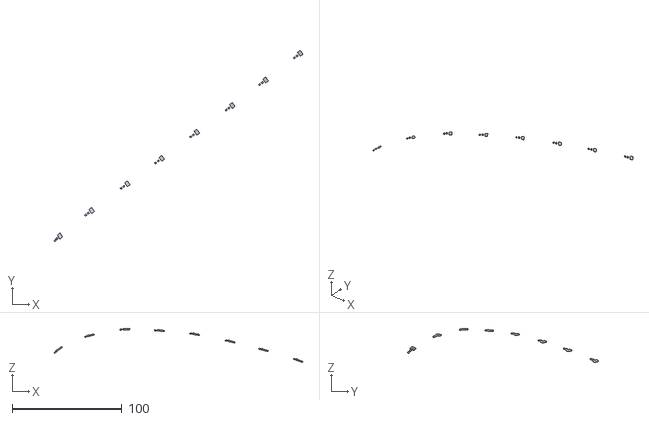
[picture p84: CAD file, 2026-11-03]
MMSA V2/cad/airfoil_testbed_4415/output/reference/parts.stl
226.9 x 174.2 x 31.1
