samam624/esp32-s3-pdm-audio-recorder/MMSA V2/cad/wing_4415/output/reference/board.stl

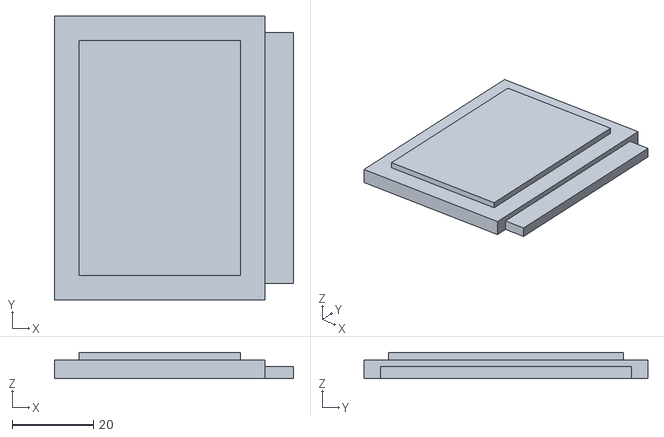
[picture p85: CAD file, 2026-11-03]
MMSA V2/cad/wing_4415/output/reference/board.stl
58.8 x 69.8 x 6.40
