samam624/esp32-s3-pdm-audio-recorder/MMSA V2/cad/airfoil_testbed_4415/output/reference/MMSA_testbed_4415_backer_only.3mf

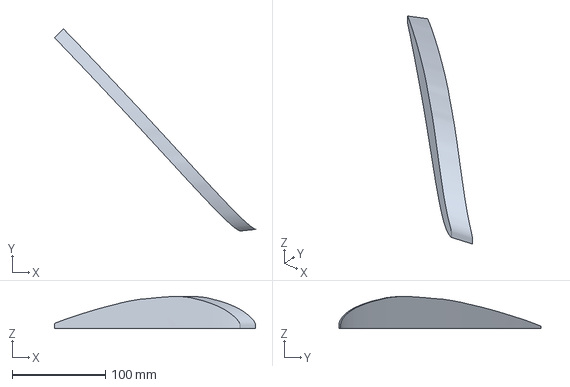
[picture p86: CAD file, 2026-11-03]
MMSA V2/cad/airfoil_testbed_4415/output/reference/MMSA_testbed_4415_backer_only.3mf
215.4 x 216.5 x 34.7 mm
