samam624/esp32-s3-pdm-audio-recorder/MMSA V2/cad/wing_4415/output/reference/parts.stl

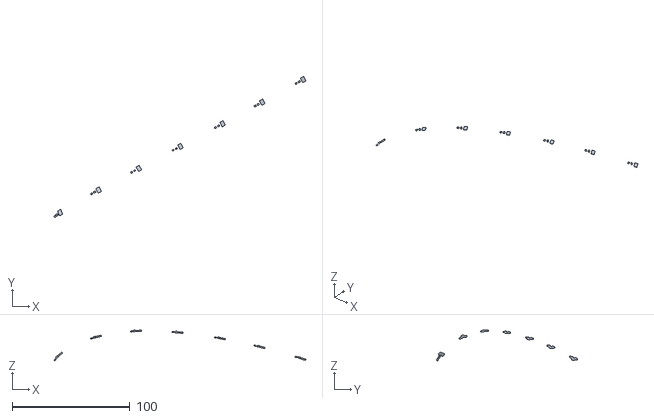
[picture p87: CAD file, 2026-11-03]
MMSA V2/cad/wing_4415/output/reference/parts.stl
214.2 x 119.9 x 26.3
