samam624/esp32-s3-pdm-audio-recorder/MMSA V2/cad/wing_4415/output/reference/backer.stl

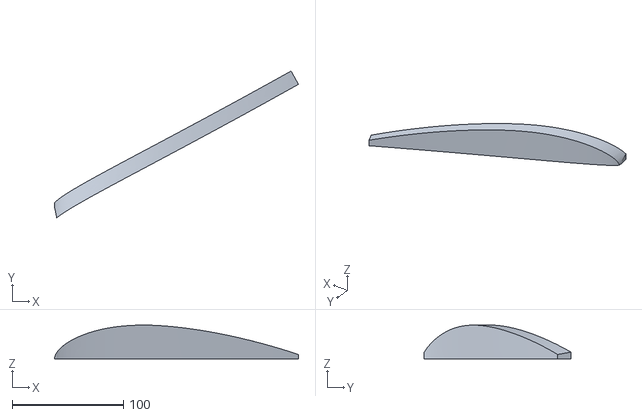
[picture p89: CAD file, 2026-11-03]
MMSA V2/cad/wing_4415/output/reference/backer.stl
219.1 x 131.9 x 30.4
