samam624/esp32-s3-pdm-audio-recorder/MMSA V2/cad/wing_4415/output/reference/flex.stl

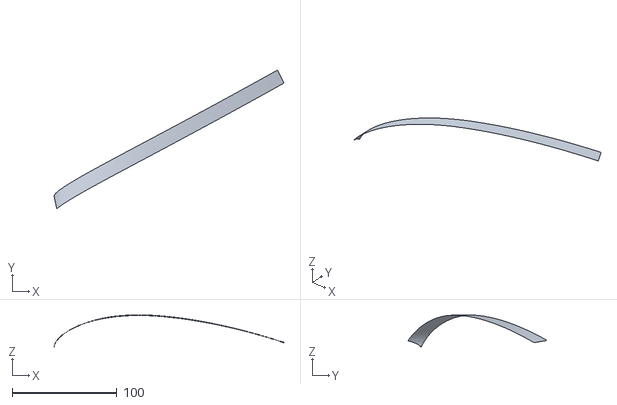
[picture p90: CAD file, 2026-11-03]
MMSA V2/cad/wing_4415/output/reference/flex.stl
219.4 x 132.4 x 30.3
