samam624/esp32-s3-pdm-audio-recorder/MMSA V2/cad/wing_4415/output/reference/battery.stl

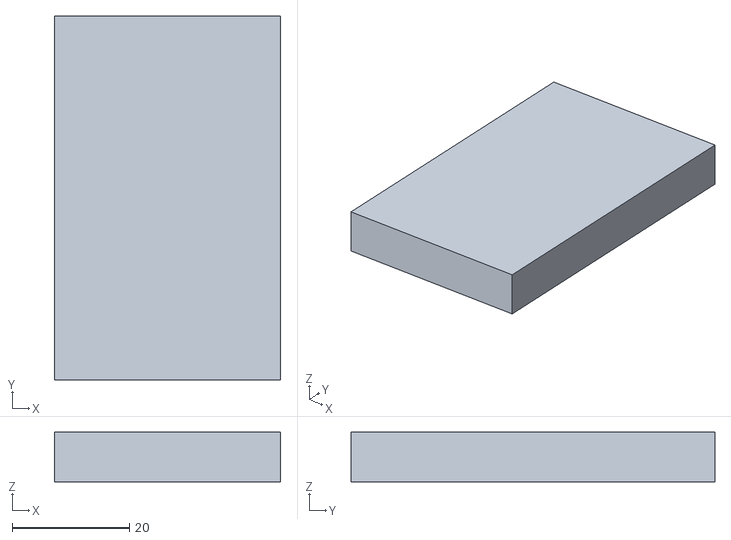
[picture p91: CAD file, 2026-11-03]
MMSA V2/cad/wing_4415/output/reference/battery.stl
38.5 x 62.0 x 8.50
