samam624/esp32-s3-pdm-audio-recorder/(list of files, cad)

Other CAD files:
MMSA V2/cad/airfoil_testbed_4415/output/MMSA_testbed_4415.step
MMSA V2/cad/wing_4415/output/reference/cover.stl
