samam624/esp32-s3-pdm-audio-recorder/MMSA V2/bringup/README.md

# MMSA V2 bring-up

## Status (2026-10-20)

| Item | Status | How verified |
|---|---|---|
| USB (native, COM5) | PASS | Enumerates as 303A:1001; esptool and serial both work |
| ESP32-S3 boot / flash / PSRAM | PASS | `MMSA_V2_SignsOfLife` (PSRAM needs `PSRAM=opi`) |
| REC button (IO35) + REC LED (IO40) | PASS | `MMSA_V2_ButtonTest`, also checked on battery (user) |
| Mic flex PCB (FPC): 3V3 and GND at every pad | PASS | User measured, on battery power |
| Battery power / power path | PASS (user) | Runs on battery; charging normal after battery reseat |
| MCP73871 charging | PROVISIONAL PASS | Normal after reseating the battery (user, 2026-10-20). Watch the battery connector if it recurs. Schematic shows -2CC (4.20 V), not -4CC as noted earlier. R1 = 15k (`18C`; changed in the BOM, the schematic still says 2k) → 67 mA charge; R2 = 10k stops at 100 mA, above the charge current, so it never tops off (~85–90%). Fix: R2 → 100k. See `reference/COMPONENT_INDEX.md` |
| SD card | PASS | `MMSA_V2_SD_Test`: 32 GB SDHC mounts, write/read/verify OK, 20 MHz = ~1180 KB/s |
| 8-ch recorder (`MMSA_V2_Recorder8`) | PASS | 33 s at 768 KB/s with 0 overflows, 0 pool drops, worst SD write 22 ms, min free 10/12 blocks |
| PDM mics (CLK IO4, data IO5–8) | 8/8 OK (2026-10-21) | Mic rail moved from 1.8 V to 3.3 V (flex data-line capacitance + 1.8 V drive broke IO7/IO8); mic4 replaced, mic7 reflowed; all 8 clean in `MMSA8_0023` |
| LEDs IO41 / IO42 | NOT STARTED | |
| Battery ADC (IO9) accuracy | PARTIAL | Reads ~3.96 V; not compared to a multimeter yet |

## 2026-10-20: signs of life (PASS)

`MMSA_V2_SignsOfLife/` prints chip, flash and PSRAM info over native USB, then a 1 Hz heartbeat. It drives no GPIOs.

Result on the first V2 board (COM5, MAC 7C:E8:B1:B9:0A:5C):
- ESP32-S3 (QFN56) rev v0.2, 240 MHz, USB-Serial/JTAG enumerates as VID 303A / PID 1001
- Flash: 8 MB quad, manufacturer 0x20, device 0x4017
- PSRAM: 8 MB **octal**, 1 MB write/read pattern test passed

## Build/flash

```
CLI="C:\Program Files\Arduino IDE\resources\app\lib\backend\resources\arduino-cli.exe"
FQBN="esp32:esp32:esp32s3:UploadSpeed=921600,USBMode=hwcdc,CDCOnBoot=cdc,CPUFreq=240,FlashMode=qio,FlashSize=8M,PartitionScheme=default_8MB,PSRAM=opi,DebugLevel=none"
"$CLI" compile -b "$FQBN" MMSA_V2_SignsOfLife
"$CLI" upload  -b "$FQBN" -p COM5 MMSA_V2_SignsOfLife
```

**Gotcha:** the PSRAM must be set to `PSRAM=opi`. With `PSRAM=enabled` (quad), the sketch reports "PSRAM: NOT FOUND". The V1 recorder FQBN uses `FlashSize=4M,PSRAM=disabled`. On V2, change it to `FlashSize=8M`. Keep `PSRAM=disabled` if the firmware reads the IO35 button (see below).

## 2026-10-20: REC button on IO35 (PASS, PSRAM disabled)

`MMSA_V2_ButtonTest/` reads IO35 (`INPUT_PULLUP`) and lights the IO40 LED while the button is held. Built with `PSRAM=disabled`, because IO35 is shared with the octal PSRAM. Result: 6 clean presses, idles high, no bounce double counts.

**The two results conflict:** PSRAM works only with `PSRAM=opi`, and the button works only with PSRAM disabled. Real firmware has to pick one (V1 picked no PSRAM), or the button needs a bodge wire to IO10/15/16.

## 2026-10-20: battery logger, charger investigation (OPEN)

`MMSA_V2_VbatLogger/` reads IO9 (VBAT/2) about 1000 times a second and prints min/avg/max every 250 ms. It also mirrors the REC button to the IO40 LED. Build with PSRAM disabled.
- Baseline with USB in: VBAT ≈ 3.95–4.05 V. Meanwhile the charger had shown STAT2 (orange, charge complete) steady, and STAT1/STAT2 flashing before that. Touching the board knocked it out of "complete".
- Suspected cause: resistance between the cell and the charger's VBAT pin (so the charger enters CV/terminates early, then recharges at VRTH), or a missing 4.7 µF VBAT cap.
- The REC button and LED still worked after the user unplugged USB (user report). That suggests the board stays running on battery through the charger's power path; not yet measured.
- The 3-minute correlated log didn't run: USB was unplugged before capture. Redo with USB in and the Arduino Serial Monitor closed.

## SD card test (prepared 2026-10-20)

`MMSA_V2_SD_Test/` is V1's `legacy/SD_Card_SPI_Diagnostic` with the card-detect pin removed (V2 has none), plus three additions:
- a 20 MHz write-speed test: 1 MB in 4 KB chunks, reports KB/s and the worst chunk time, then reads back and verifies
- REC button reruns the test
- REC LED shows the result: solid = pass, fast blink = fail

It runs on boot and prints a `RESULT:` line at the end. Build with `PSRAM=disabled`.

## 2026-10-20: SD card (PASS)

Card: 32 GB SDHC (30436 MB), the V1 card with REC_00001–00024 still on it (the test only appends to `sd_diag.txt` and creates/deletes `speed_test.bin`).
- Raw SPI and low-level init: CMD0/CMD8/ACMD41 reached ready, OCR 0xC0FF8000
- Mounted at 100 kHz and at 20 MHz. Append, read back and directory listing all OK
- 20 MHz write: 1 MB in ~865 ms = **~1180 KB/s**, chunk avg 3.4 ms, worst 5.6 ms, read-back verify PASS
- Headroom: 8 mics × 16-bit × 48 kHz = 768 KB/s, so about 1.5×. Fine in bursts, but a recorder still needs a RAM buffer to ride out the occasional long stall a card does during real recordings (this 1 MB test is too short to show those).
- Fixed an inherited V1 bug: file sizes printed as garbage (`size_t` passed to `%llu`). V1's `legacy/SD_Card_SPI_Diagnostic` still has it.

## 2026-10-20: first mics (MIC 0 + MIC 1 on data line IO5): audio OK, L/R duplicated

`MMSA_V2_MicTest/` is the live 8-slot level meter. IO41 brightness follows the loudest slot, and IO42 is a 1 Hz heartbeat (this also exercises those two LEDs). `MMSA_V2_MicDiag/` cycles through PDM configurations and measures how alike slots 0 and 1 are.

- Audio is present and reacts to sound: quiet room ~ -50 to -55 dBFS, loud ~ -14 dBFS.
- **Slot 0 and slot 1 (IO5 L/R) are the same stream:** identical in 100% of PCM samples (correlation 1.000), and **99.9–100% of raw PDM words**. Two mics on opposite clock edges can't be bit-identical, so one stream is reaching both edges. Likely causes:
  1. Both mics' SELECT (L/R) pins strapped to the same level, so both drive the same edge and fight.
  2. One mic isn't driving (bad joint or dead), and the data line holds its last bit through the other half-cycle.
- PCM with all 8 slots: accepted by the driver. Slots 2–7 (no mics fitted) sit at a constant -30935 with zero variance. It isn't yet proven that the hardware PDM→PCM filter really converts lines 1–3; confirm when a mic is fitted on IO6/7/8.
- RAW with all 8 slots: refused (`i2s_pdm_rx_set_clock: clock calculate failed`) at 3.072 MHz. RAW with 2 slots works. Not needed if the PCM route works on all lines.
- Mic is the **IMP34DT05** (datasheet saved). The flex schematic shows the LR straps are correct (MIC_L LR → GND, MIC_R LR → 1V8), so the duplicate means one mic isn't driving `DO`. See `reference/MIC_FLEX_MODULE.md` for suspects and the cover-one-port test.
- LED oddities during `MMSA_V2_MicTest` were not hardware: `MMSA_V2_LedProbe` found no bridges and each pin driving correctly, and a register dump showed all three LED pins configured correctly. After a clean serial reset the LEDs behaved. Suspect the board came up in a bad state after the flasher's reset; replug if LEDs freeze after a flash.

## 2026-10-20: corrections after an external code review

- **The mic L/R duplicate is NOT diagnosed as hardware.** The data shows the two slots are near-identical; it can't separate a dead or unsoldered mic, routing, or an ESP32-S3 driver/config limitation. `MMSA_V2_MicDiag` now runs a cover test (one mic's port covered, steady sound; compare LEFT-edge vs RIGHT-edge mono levels) to tell these apart. Taps aren't a valid per-mic test, because vibration travels through the flex to both mics.
- `MMSA_V2_MicTest`: removed the raw-PDM fallback. The driver rejects 8 raw slots at 3.072 MHz, so it could never have worked. The `ledcAttach` result is now checked. The PCM 8-slot mode is still **unvalidated** on lines 1–3.
- `MMSA_V2_MicDiag`: removed the 8-slot RAW experiment (always refused).
- The "snap turned IO40 off" observation is **unexplained**. IO40 is written only from the REC button, so it means LED misidentification, a REC button glitch, or coupling. The "bad boot after flash" explanation was a guess, not a finding.
- `MMSA_V2_SD_Test`: the append test now writes a unique token and confirms it reads back. Before, it only printed the file, which proved nothing about the new write.
- Reminder: `reference/` is hand-built from user statements and screenshots, not a CAD netlist. Treat anything marked assumed/TBD/placeholder accordingly.

## 2026-10-20: press test: one mic has an intermittent joint (hardware)

`MMSA_V2_PressTest/` is raw PDM on line IO5, comparing LEFT-edge vs RIGHT-edge words every 500 ms. Same firmware and config throughout.
- At rest: **99.8–100% identical** (one stream on the line).
- While the user pressed one mic (log uptime ~71–98 s): **18–20% identical (two distinct streams)**, steady the whole press.
- After release: back to ~100% within 2 s.
- Since the firmware can produce two distinct streams, the duplicate isn't a driver limitation. One mic's joint only connects under pressure. **Confirmed MIC 0**: holding MIC 0 alone gave a steady ~18.7% identical (two streams).
- If the bad joint is on MIC_R's **LR** pad, it's an especially good fit: an open LR falls back to the internal 200 kΩ pull-down, so MIC_R acts as a LEFT mic and both drive the same edge. An open DOUT/CLK/VDD on either mic fits too.
- Fix: reflow that mic (flux, hot air or hot plate). Remember the 3-reflow limit.
- Rework attempts on MIC 0 (left mic, LR=GND): two reflows plus pressing it down while the solder set. Still one stream at rest and two streams when pressed (left-edge density 0.43 vs 0.50 for the healthy mic). Next suspects: a cracked flex trace/via near MIC 0, or a damaged mic/pad (now at ST's 3-reflow limit). `MMSA_V2_PressTest` now lights the REC LED (IO40) while two streams are present, so the user can probe without serial.
- **Correction:** the press-test "two streams" was **not** MIC 0 connecting. The user found that a light finger touch anywhere on the flex between MIC 1 and the FPC (or a half-inserted FPC) triggers it. That's finger capacitance disturbing the undriven, floating left half-cycle of the DO line. Conclusion: MIC 0 doesn't drive the line at all. The test now also requires the left stream to toggle like real PDM before it counts as a mic.

## 2026-10-20: stereo SD recorder for listening tests

`MMSA_V2_StereoRecorder/` uses the same PDM config as V1's recorder (48 kHz, PCM stereo, CLK IO4, DIN IO5). REC toggles recording to `/MMSA_NNNN.wav` (LEFT = MIC 0, RIGHT = MIC 1), and the REC LED is on while recording. It reports DMA overflows on stop.
- Note: the user says the mics run from a **1.8 V LDO** fed from the 3V3 rail. On paper that's outside both datasheets: the 3.3 V CLK exceeds the mic's Vin abs max of Vdd+0.3 = 2.1 V (IMP34DT05 Table 5), and the 1.8 V DOUT high is below the ESP32-S3's VIH min of 0.75×3.3 = 2.48 V (WROOM-1 datasheet). The user reports the same 1.8 V setup worked in V1. Recorded as a risk to revisit (level shifting, or running the mics at 3.3 V; they're rated to 3.6 V), not as the cause of the MIC 0 issue.
- **Listening test (MMSA_0001.wav, 16.7 s, 0 DMA overflows):** the user hears MIC 0 on both channels, so **MIC 1 is the mic that isn't getting in.** That reverses my earlier MIC 0 attribution, and MIC 0 was reworked unnecessarily (now at 3 heat cycles). The bit-level data (one stream on the line) still holds; only *which* mic was wrong.
- **ROOT CAUSE (user, 2026-10-20): MIC 1 had no solder on any of its inner signal pads** (only the outer ring was joined). Reworked, and now **both mics on module 1 work** (user-confirmed by listening).
- Lessons for the remaining 6 mics: (1) LGA mics need solder on every inner pad. Pre-tin the pads or use paste/stencil, and don't rely on the ground ring wicking. (2) The "identical L/R slots" check reliably detects a missing mic on a line, but **it can't tell which mic**. Edge/slot-based attribution was wrong here. Identify the mic by listening with one port covered (`MMSA_V2_StereoRecorder`). (3) A finger on the DO trace disturbs the floating half-cycle and fakes a second stream; don't touch the flex during the test.
- **LED roles (user-defined 2026-10-20), now in `MMSA_V2_StereoRecorder`:** IO40 = record ready (solid while the SD card is mounted, live presence check plus auto-remount), IO41 = loudness meter (V1 level math, always active), IO42 = REC blink (400 ms while recording). Note this differs from V1, where 40 = REC, 41 = level, 42 = SD.

## 8-channel recorder (prepared 2026-10-20, not yet run)

`MMSA_V2_Recorder8/`: same PDM setup as the stereo recorder, with all 4 data lines and all 8 slots enabled. It writes `/MMSA8_NNNN.wav` (8 ch: ch1-2 IO5, ch3-4 IO6, ch5-6 IO7, ch7-8 IO8; L/R order within each pair unverified) and uses the same LED roles. While idle, every 2 s it prints per-channel levels and flags pairs that are bit-identical (one mic not driving) or flat (no data). 768 KB/s against ~1180 KB/s SD; ~133 ms DMA buffer. First run will also tell us whether 8-slot hardware PCM really converts lines IO6–IO8.
- **First 8-ch run (mics 0–5 fitted, 6–7 not):** the hardware PCM filter **does convert lines IO6 and IO7** (8-slot mode validated for lines 1–2; IO8 has no mics yet). Idle, signal (DC removed): ch1 −50..−54, ch2 −51..−54, ch3 −51..−55, ch5 −50..−54 dBFS (healthy room noise, DC within ±250). **ch4: DC ≈ −28,600 with −22 dBFS noise** (abnormal, close to the −30,935 "no data" value). **ch6: DC ≈ −1,040 with a steady −30 dBFS noise floor** (abnormal, ~20 dB noisier than the others). ch7–8: constant −30,935 (no mics). Which physical mics are ch4 and ch6 is NOT inferred from slot order; identify by a listening/cover test.
- User inspection: **tombstoning on mic 3 and mic 5** (one on each of modules 2 and 3), which matches the two abnormal channels (ch4 on IO6, ch6 on IO7). Rework in progress.
- After the tombstone rework: **ch6 is fixed** (−50 dBFS, DC −200). **ch4 is still abnormal**: DC −29,134 (near the −30,935 empty-line value), −38 dBFS residual noise. One mic on IO6 still isn't driving properly (user suspects mic 3). ch1, 2, 3, 5, 6 healthy.
- **Mic numbering from now on: mic0–mic7 = channel index 0–7** (WAV track N+1 = mic N). The bad channel is **mic3** (IO6); mic5 is fixed. `MMSA_V2_Recorder8` output now uses mic0–7 labels and flags rail-pinned channels as ABNORMAL.
- After the mic3 rework: **all 8 mics flat** in `MMSA_V2_Recorder8`, and the independent raw test (`MMSA_V2_PressTest`) shows **IO5 held solid low: density 0.000, zero toggles** (it was ~0.50 when healthy). No mic on the flex is driving data. Firmware ruled out (two separate sketches, both previously working). Suspect power/clock/connector on the flex, likely a short on the 1V8 rail from the rework.
- `MMSA_V2_ClockCheck/` (samples the real pad levels): **CLK IO4 toggles normally at the ESP32 pin (high 47% of the time)**, so no hard short on the clock at the board side. **All 4 data pins sit at 0 with zero toggles.** The user confirmed 1V8 is present at every mic's caps. Remaining suspects: the clock not reaching the mics (FPC contact on the CLK pin, or a broken/bridged CLK trace on the flex near mic3), or the data path at the connector.
- `MMSA_V2_MicLineShorts/` (GPIO-level short check, board side): **data lines IO5–IO8 behave normally** (follow their pulls, no line follows another, no shorts). **CLK (IO4) reads HIGH even with its pull-down**, but the ESP32 can still drive it LOW. So something ties the clock net to a supply through some resistance: not a hard short, but stronger than the ~45 kΩ internal pull-down. (The "CLK follows Dx" flags are artifacts of CLK always reading high.) There's no pre-rework baseline for this test. Leading suspect: a resistive CLK→1V8 bridge at mic3 (on the LGA, the CLK pad sits next to VDD/LR), dragging the mics' clock low level out of spec. Confirm with an ohmmeter, CLK to 1V8, board unpowered.
- After the user's fix: **CLK no longer pulled up** (reads 0 with pull-down), and **mic0, 1, 2, 4, 5 are back**: signal −52.5 to −53.5 dBFS, DC within ±350. **mic3 is still abnormal** (DC −29,198, −37.5 dBFS), the same as before the clock problem. mic6–7 not fitted.
- New mic3 fitted: **all lines dead again.** Short check: **CLK (IO4) can't be driven HIGH = hard short to GND** (new; the previous fault was a resistive pull toward a supply). D1–D3 (the lines with mics) read LOW against their pull-ups, which is likely the unclocked mics holding DOUT low; IO8 (no mics) behaves normally. Suspect: the new mic3's CLK pad bridged to its ground ring.
- Fresh mic3, CLK short cleared: **line short check clean**, and **mic0–mic5 all healthy**: signal −48.3 to −48.9 dBFS, DC −360..+47. 8-slot hardware PCM confirmed working on IO5, IO6 and IO7. Remaining: mic6–7 on IO8, and a long 8-ch recording to check SD throughput (768 KB/s).
- **First 8-ch throughput test: FAIL.** `MMSA8_0001.wav`: 14.3 s audio in 14.8 s wall, **234 DMA overflows (~0.5 s / 3% lost)**. The single-loop design (SD writes blocking the I2S drain, 4 KB writes, ~133 ms DMA buffer) can't sustain 768 KB/s.
- `MMSA_V2_Recorder8` reworked to V1's architecture: an I2S reader task on core 0 fills a RAM block pool (up to 12 x 16 KB = 192 KB, ~256 ms); loop() writes full 16 KB blocks to SD. The stop report now shows DMA overflows, pool drops, worst SD write time and minimum free blocks. Compiled, not yet run. Fallback if it still drops: a faster SD clock, or the IO35 button bodge to free the 8 MB PSRAM for large buffers.
- **Reworked 8-ch recorder: PASS on a short test.** `MMSA8_0002.wav`: 12.3 s audio = 12.3 s wall, **0 DMA overflows, 0 pool drops**, worst SD write 47.8 ms, min free blocks 9/12 (used ~64 ms of the ~256 ms pool). The earlier "buzzy/distorted" recording came from the OLD single-loop firmware (the rewrite hadn't been flashed yet); its frequent drops caused the buzz. Still to do: a multi-minute recording to catch rarer, longer SD stalls.
- **User: `MMSA8_0002.wav` still sounds buzzy/distorted despite zero drops.** So the problem is in the audio data, not storage. Prime suspect: the hardware PDM→PCM filter running 4 lines / 8 slots (the 2-slot stereo recorder sounded fine). Back to basics: `MMSA_V2_MonoRecorder/` (stereo recorder with a single slot: mic0, IO5 left, `/MMSA1_NNNN.wav`) to re-establish a clean baseline. Next: compare 1 slot vs 2 slots vs 8 slots, ideally by analyzing the WAVs on the PC.

## 2026-10-20: buzzy 8-ch audio, analysis of `MMSA V2/data/*.wav`

Scripts in the session scratchpad (not in the repo): channel continuity, correlation, harmonic-comb buzz detector, band levels.
- **Interleaving is correct**: every 8-ch track is continuous audio (lag-1 autocorrelation ~0.98–1.00). The firmware isn't mixing channels.
- **No tonal buzz** (no harmonic series stands >~3.6 dB above neighbours in any file), so it isn't mains hum or a fixed-rate glitch.
- **Speech-band (300–3000 Hz) correlation:** stereo `MMSA_0004` mic0↔mic1 = 0.79. In `MMSA8_0002`, mic0↔mic1 = only 0.27 and all pairs 0.13–0.43. The mics agree much less than expected, which looks like added non-acoustic noise or errors.
- **Low-frequency excess:** 20–100 Hz is −28 to −34 dBFS in the 6-mic-era files (`MMSA1_0001` mono AND `MMSA8_0002`) versus −39 to −49 in the 2-mic stereo files, plus large sub-20 Hz energy (−14 to −25 dBFS) that the 35 Hz high-pass should be removing.
- **Key point:** `MMSA1_0001` (1 slot, 1 data line, the *old* firmware path) was recorded with 6 mics fitted and shares the 8-ch file's spectral signature. That points at a **hardware change between the 2-mic and 6-mic builds**, not at the 4-line firmware. Not a controlled comparison yet (different sounds recorded).
- **Leading hypothesis (from the datasheets):** the 3.3 V CLK into mics on a 1.8 V supply exceeds the IMP34DT05 Vin max of Vdd+0.3 = 2.1 V. Each mic's CLK protection diode conducts into the 1V8 rail, and with 6 mics the injected current can lift or modulate a rail that the LDO can't sink. Separately, the 1.8 V DOUT high is below the ESP32-S3's VIH min of 2.48 V, so marginal levels and rail noise can turn into PDM bit errors (heard as noise/distortion). Both scale with the number of mics, which fits "2 mics clean, 6 mics bad".
- Proposed tests: (A) listen to `MMSA1_0001`; if it's buzzy, the 4-line firmware is cleared. (B) Measure the 1V8 rail with the clock running (recorder) vs stopped (`MMSA_V2_MicLineShorts`); a rise with the clock running confirms injection. (C) Controlled re-record with the stereo recorder now that 6 mics are fitted. Candidate fixes: power the mics from 3V3 (IMP34DT05 is rated 1.6–3.6 V, which fixes both CLK and DOUT levels), or level-shift CLK/DOUT. A cheap firmware experiment: a lower PDM clock (32 kHz → 2.048 MHz) for more timing margin.
- **Correction / likely explanation:** the user heard mic0 hard left, mic1 hard right, and the others centered or slightly off. That's a player treating the plain 8-ch WAV as **7.1 surround** and downmixing (track 3 = center, **track 4 = mic3 = LFE, low-passed: sounds buzzy**, tracks 5–8 = surrounds), plus phasey summing of spaced mics. The buzz may well be a **playback artifact**; the per-track analysis found every track intact. The hardware-voltage hypothesis above is now unconfirmed and secondary. Added `MMSA V2/tools/split_wav.py` (one mono WAV per mic) and split `MMSA8_0002` into `data/split/` for per-mic listening.
- **`MMSA1_0002.wav` (mono, mic0, 6 mics fitted, board left undisturbed): user says it sounds perfect.** Numbers agree: sub-20 Hz −51.9, 20–100 Hz −49.9, 1–4 kHz −36.5 dBFS, DC −136, 1.6% sample jumps (cleaner than the 2-mic stereo files). **The hardware-voltage hypothesis is not supported**; the 6-mic build records cleanly. The rumble in `MMSA1_0001`/`MMSA8_0002` was most likely the recording conditions (handling), and the "buzzy" 8-ch playback the 7.1 downmix. Next: a fair 8-ch recording under the same conditions, split per mic.

## 2026-10-20 end of day: mic4 confirmed bad; where we left off

**Fair 8-ch test `MMSA8_0003.wav`** (board undisturbed, 33.3 s, no audio lost). Per-mic analysis (`tools/wav_noise_floor.py`) and the user's per-mic listening agree:
- **mic0–3: clean.** Same noise-floor shape as the "perfect" mono file `MMSA1_0002` (falls off above ~12 kHz), speech-band correlation 0.60–0.96 between them.
- **mic4: BAD, confirmed by the user's listening.** Flat ~−89 dB broadband hiss from 200 Hz to 20 kHz (bit errors or a marginal joint). It was also the glitchiest channel in `MMSA8_0002`. In any mixdown its hiss covers every mic.
- **mic5: suspect.** The noise shape is fine, but its speech level is 5–10 dB below the others and correlation with them is 0.03–0.34. Possibly a partly blocked port (flux/solder) or a weak joint.

**Conclusions from today's audio debugging**
- The 8-ch firmware and the 4-line hardware PDM→PCM path work (channel interleaving correct, no drops).
- The earlier "buzzy 8-ch" files had three causes stacked: the old single-loop firmware dropping audio (`MMSA8_0001`), handling rumble (`MMSA8_0002`, `MMSA1_0001`), and **players downmixing 8-ch WAVs as 7.1 surround**. Always listen with `tools/split_wav.py` or Audacity tracks.
- The 1.8 V mic supply vs 3.3 V logic concern was **not** the cause (6-mic mono recording is clean). It's still outside the datasheet limits on paper, so it's a risk to keep in mind, not an active issue.

**Next session**
1. Rework or replace **mic4** (check DOUT/CLK/VDD/ground ring; don't bridge CLK to the ring or VDD, as happened twice on mic3).
2. ~~Inspect mic5~~: mic5 confirmed clean by listening (2026-10-20).
3. Fit **mic6–7** (IO8), pre-tinning every inner pad.
4. Run the line short check (`MMSA_V2_MicLineShorts`) after each rework, then the `MMSA_V2_Recorder8` health check, then an undisturbed recording, split and analyzed per mic.
5. A long (5–10 min) 8-ch recording for SD stall margin.
6. Optional firmware: WAV header without speaker positions, so players don't downmix as 7.1.
- **Update (user, same evening):** **mic5 is clean** by listening, so the low correlation was not a fault. **Unpopulated mic6/mic7 pads add buzz**: the empty IO8 line floats and the filter output glitches (seen earlier as a 16 Hz comb in the empty channel of `MMSA8_0002`). `MMSA_V2_Recorder8` now (a) enables internal pull-downs on data lines IO5–IO8, so an undriven line settles low, and (b) writes **unfitted mics as digital silence** via `MIC_FITTED[8]` (currently mic0–5 true, mic6–7 false; set them true when fitted). Compiled, not flashed yet.

## 2026-10-21: "REC dead, loudness LED always red" (fixed)

- The board was running an **older `Recorder8` build** (the MIC_FITTED version had never been flashed), most likely built with PSRAM enabled: recording worked over serial (`r`), but the IO35 REC button did nothing. Reflashed with the README FQBN and **`PSRAM=disabled`**. The sketch now prints a warning at boot if PSRAM is enabled, and prints `REC button pressed` on each press.
- **Loudness LED pinned on:** the level calculation included the empty mic6/7 channels, which sit at a constant −30935 (≈ 0.94 of full scale). It now uses fitted mics only, with DC removed.
- **The data-line pull-downs added last session were harmful:** with them, mic1 went dead (DC −30935), mic4 pinned near −20000 and mic5 degraded; removing them brought all three straight back (mic0–5 at −50 dBFS, DC within ±300). Possibly marginal DOUT drive (1.8 V mics into 3.3 V inputs, or weak joints) losing against the ~45 kΩ pull-down. **Don't add pull-downs on IO5–IO8.** Unfitted mics are still muted in the WAV via `MIC_FITTED[]`.
- **REC button "dead" with USB plugged in (actual cause, found by the user):** REC worked on battery and failed whenever USB was connected to the PC. The ESP32-S3 USB serial (HWCDC) blocks each print for up to 100 ms (up to ~2 s total) when the PC end isn't reading, and `Recorder8` prints a status block every 2 s, so loop() stalled long enough to miss presses. Opening the port from a script also resets the board (DTR/RTS). It was never PSRAM or GPIO26 related (an earlier note here blaming a floating PSRAM chip select was wrong; that code is removed). **Fix in `Recorder8`:** `Serial.setTxTimeoutMs(0)` right after `Serial.begin()`, and the REC button is latched by a CHANGE interrupt with debounce (a falling edge counts only after >= 50 ms released, 250 ms lockout), so a busy loop can't drop a press. Apply the same two fixes to any V2 firmware that prints over USB and reads the button.
- **mic4 replaced (fresh mic), same hiss:** `MMSA8_0011` mic4 quiet floor flat ≈ −91 dB from 2–20 kHz, within ~1 dB of the old mic in `MMSA8_0010`; mic0–3, mic5 clean (−117 to −126 dB above 12 kHz). It hears the sound (0.77–0.80 speech-band correlation with mic1–3) but with added white noise, which looks like PDM bit errors. Two different mics with an identical signature points at **mic4's footprint/joints (CLK, DOUT, LR, decoupling) or the IO7 left-edge timing/level margin**, not the mic part.
- **Lower-clock test failed for everything:** `MMSA8_32k_0001` (SAMPLE_RATE 32000, PDM clock 2.048 MHz, within the mic's 1.2–3.25 MHz) came out as white noise at −65 dB on **all six mics**, uncorrelated (lag-1 −0.07). So the ESP32 PDM→PCM path doesn't work at 32 kHz with this config; the test says nothing about mic4. Recorder8 is back at 48000. Non-48 kHz recordings are named `/MMSA8_<rate>k_NNNN.wav`.
- **mic4 footprint emptied (`MMSA8_0013`–`0015`):** the empty mic4 slot is NOT a copy of mic5 (only 5–10% identical; IO5's empty slot was 100% identical on 2026-10-20). In a quiet room it is **pure random bits**: flat −81 dB/Hz, lag-1 0.00, −36 dBFS, same level quiet or loud. So during mic4's half-cycle the IO7 line sits near the input threshold instead of holding mic5's last bit. A fitted mic mostly but not fully overrides it (−91 dB hiss on two different mics).
- **SD-crosstalk snapshot test (`SNAP_0001`, hold REC 1.5 s; analyze with `tools/snap_compare.py`): SD ruled out as the main cause.** Empty mic4 slot −36.6 dBFS with the SD bus silent vs −35.1 dBFS busy (a consistent ~1.5 dB SD contribution in all 8 pairs); other mics unchanged at −126..−128 dB in 4–20 kHz. The 90° SD/data crossings are fine.
- **Next:** unpowered resistance IO7 → GND / 1V8 / CLK compared with IO5 (look for a soft leak on IO7 only), IPA clean of the mic4/mic5 module, the FPC IO7 pin and ESP pin 7; scope IO7 vs IO5 if available. (VDD→GND at mic4 reading ~30 kΩ then rising to open is the decoupling caps charging, normal.)
- **Unpopulated reference flex (2026-10-21):** all four data lines read flat −30935 (idle low, no noise) in `Recorder8`; user measured FPC→ESP continuity OK on all four. `MMSA_V2_MicLineShorts` (now with a line-timing section): **no shorts**, but edge time through the internal ~45 kΩ pull rises steadily IO5 → IO8, very repeatable:

  | line | rise via pull-up | fall via pull-down | hold HIGH floating | hold LOW floating |
  |---|---|---|---|---|
  | IO5 | 1295 ns | 1070 ns | 58 ms | > 2 s |
  | IO6 | 1858 ns | 1633 ns | 238 ms | > 2 s |
  | IO7 | 2533–2645 ns | 2195 ns | 623 ms | > 2 s |
  | IO8 | 3287–3320 ns | 2870 ns | 46 ms | > 2 s |

  Edge time ≈ 0.69·R·C, so line capacitance is roughly **~40 / 60 / 80 / 105 pF** for IO5/6/7/8 (absolute ±40% from the pull-resistor tolerance; the ratios are solid, IO8 ≈ 2.5× IO5). The IMP34DT05 allows **CLOAD ≤ 100 pF** and specifies its output only at 1 mA (≈ 10 V/µs into 100 pF, so ~165 ns to swing 1.65 V, the whole 163 ns half-cycle at 3.072 MHz). This ranks exactly like the failures: IO5/IO6 clean, IO7 marginal (mic4 hiss), IO8 failing on both slots. Leakage is negligible (nA; holds are ms–s). **Leading explanation: too much capacitance on the longer data lines for the mics' weak DOUT drive.** Next: same test with no flex inserted, to split board vs flex capacitance.
- **Same timing test with NO flex inserted:** every line 283–395 ns rise / 229–283 ns fall (≈ 8–12 pF, board + ESP pad; equal across lines within the loop's ~56–112 ns granularity). So **the flex adds the capacitance**: about +1.0 / +1.6 / +2.2 / +2.9 µs ≈ **33 / 51 / 71 / 94 pF** on IO5/6/7/8. The user says the mics are evenly spaced from the connector out to 300 mm (mic0 closest, mic7 farthest), so that's roughly **0.25 pF/mm** of flex trace, linear in distance (typical of a trace over a thin polyimide dielectric). IO8's ~95 pF plus two mic pins is at the IMP34DT05's 100 pF CLOAD limit.
- **User confirmed the mics run at 1.8 V.** That makes it much worse: a 1.8 V DOUT has to climb to ~83% of its swing to cross a ~1.5 V ESP32 input threshold (≈1.8 RC time constants, vs ≈0.7 at a 3.3 V supply), and is below the ESP32's guaranteed VIH (2.48 V) anyway. Slow rising edges that miss the sample point read as 0, matching the large negative DC on mic6/mic7. The 3.3 V CLK into 1.8 V mics also exceeds the mic's CLK abs max (Vdd + 0.3 V = 2.1 V).
- **Conclusion: root cause of mic4/mic6/mic7 is the long flex data lines (capacitance grows with distance) driven by 1.8 V mics, not solder joints.** Fix options, most effective first: run the mics at 3.3 V (IMP34DT05 is rated 1.6–3.6 V; also fixes the CLK abs-max violation; check what else is on the 1V8 rail first); add a buffer at the far modules; lower the PDM clock (32 kHz broke the ESP32 converter; untested between); next flex revision: narrower data traces / thicker dielectric / per-module buffering.
- **Mic supply moved to 3.3 V (user removed the 1V8 LDO and jumpered 3V3 onto the mic rail; nothing else was on 1V8): FIXED the line problem.** Live status: all eight channels at normal room levels with small DC; IO8 went from DC −5271/−9562 random noise to normal. With the old mic4 footprint empty, slot 4 now follows mic5 cleanly (healthy-line behaviour).
- **Fresh mic4 at 3.3 V (`MMSA8_0021`): clean.** 12–20 kHz quiet floor −123 dB, the same as mic0–3/mic5 (it was −91 dB at 1.8 V); lag-1 0.87; 0.97 speech-band correlation with neighbour mic3. No added noise from sharing the 3V3 rail (all floors −121..−125 dB).
- **IO8 pair 100% bit-identical** in `0021`/`0022`: one of mic6/mic7 not driving. Cover test in `0022` was ambiguous from the data alone (both covers dropped IO8); the user isolated it to **mic7** (dead) and is reflowing it. mic6 working.
- **mic7 reflowed (`MMSA8_0023`): ALL 8 MICS WORKING.** IO8 pair 0.2% identical (independent), mic6/mic7 DC +25/+42; every mic's 12–20 kHz quiet floor −119..−121 dB, lag-1 0.84–0.93, DC −375..+42. Remaining from the plan: a long (5–10 min) 8-ch recording for SD stall margin, and optionally a WAV header without speaker positions.

## 2026-10-21: battery logger in `Recorder8` (overnight run-down test)

`Recorder8` now logs VBAT (IO9, ×2) to **`/BATLOG.CSV`** on the SD card: a `# boot, reset=<reason>, vbat_mV=…` line on every power-up (a `BROWNOUT` reset reason shows a dying battery), then `uptime_s,vbat_avg_mV,vbat_min_mV,vbat_max_mV,recording` every 30 s (VBAT sampled every 250 ms). Each line is appended and the file closed, so the log survives the battery dying. Below **3.40 V** (interval average) it writes a final line, stops any recording, and stops using the SD card to protect it from a brownout mid-write (IO40 goes off). It also refuses to touch the card if it boots below 3.40 V. Note: opening the serial port resets the board, which starts a new boot section. First reading on USB: 4060 mV. Read back with `tools/batlog_analyze.py BATLOG.CSV` (runtime, VBAT timeline, estimated average current; SoC from a typical LiPo curve, so ±20%; the ADC hasn't been checked against a meter).
- ADC check (user's multimeter, 2026-10-21): battery 4.15 V with USB in (logger read 4.06 V avg, 3.98–4.13 V), 4.07 V off USB. One point, and the charger state on USB may differ between the two readings, but the ADC looks ~90 mV (~2%) low; `batlog_analyze.py --offset-mv 90` applies that.
- **Overnight result (2026-10-22 morning, user):** board dead, battery 3.0 V at rest, no voltage on the board. Most likely the cell's protection circuit tripped after the board drained it (the 3.40 V logger cutoff only stops SD writes; the board keeps running). **To do next session:** analyse `BATLOG.CSV` (runtime, average mA, whether the `# LOW BATTERY` line or `BROWNOUT` boots appear), then add a proper low-battery shutdown to `Recorder8`: stop the PDM clock (mics drop to ~5 µA), LEDs off, ESP32 deep sleep, wake on REC/USB, threshold chosen from the log. Recharge the cell before reusing it; avoid repeated deep discharges.
- **BATLOG.CSV analysed (2026-10-23, `data/batlog/BATLOG.CSV`, +90 mV offset):** one boot, never recording (idle draw: CPU, PDM clock, 8 mics, LEDs). USB unplugged ~2.5 min in (4.15 V on USB, then 4.075 V, matching the meter's 4.07 V). After that it took **107 min from 4.07 V to the 3.49 V cutoff** (logged as 3.40 V raw), falling steadily at ~5.5 mV/min (6 mV/min early, ~4.3 mV/min near the end). Crossing times: 4.0 V at 9 min, 3.9 V at 25, 3.8 V at 43, 3.7 V at 62, 3.6 V at 82, 3.5 V at 106. Estimated average current **~70 mA** (±20%), so a full 150 mAh lasts ~2 h idle. The `# LOW BATTERY` line is present. No BROWNOUT boots could be logged, because the card is left alone below the cutoff. The cutoff left only ~4% (~6 mAh, ~5 min), and after that the board drained the cell to its protection trip. Within each 30 s window VBAT varies by ~145 mV (min to max), so the shutdown should use the average, not the min.
- **Recharge from flat (2026-10-23, user):** 3.3 V → 3.7 V in 72 min on USB (~5.5 mV/min, the same rate it drained). Using the discharge log as this cell's curve, that's roughly **40 mA into the battery (25–55 mA)**, about 0.25C, so ~4–4.5 h from flat to full. The schematic (user screenshot) rules out the current settings: PROG2 = 3V3 (500 mA USB limit), SEL = GND, R1 = 2k (I_REG 500 mA), R2 = 10k (stops at 100 mA). The charger should be pushing ~400 mA, ten times the estimate. Still open, three candidates: (a) VPCC is cutting the current because IN is sagging (VPCC wiring not yet seen); (b) the charge ran fast, then stopped early at the 100 mA cutoff (the cell/connector resistance makes the charger see 4.2 V early), and the cell has sat at 3.7 V since; two readings can't tell (a) from (b); (c) stuck in preconditioning (10% = ~50 mA, matches the estimate, but VBAT is above V_PTH ≈ 3.0 V, so unlikely). LEDs (user, 13:2x): D1 green (PG) + D3 blue (STAT1) on, orange off = **actively charging**, which rules out (b). A stop in CV would also show orange, because 40 mA is below the 100 mA cutoff. Leading suspect: (a) VPCC throttling because IN is sagging (series diode, fuse, weak port, or long cable). Next: find where VPCC goes (divider sets IN threshold = 1.23 V × (Rtop+Rbot)/Rbot), measure IN while charging, and try a wall charger with a short cable. The board booted at ~3.3 V (below the 3.40 V cutoff), so BATLOG didn't record this charge. A reset now (battery > 3.4 V) would start logging the charge curve. User measured **5.15 V coming in while charging** (laptop USB-A port), so no sag. That doesn't fully clear VPCC: VPCC holds IN at its threshold, so a divider set near ~5.1 V would look exactly like this. Still need the VPCC divider values and a confirmed R1 value (a 20k misread as 2k would give ~50 mA). For a definitive number, put a meter in series with the battery lead. **VPCC is tied to VBUS (user), so VPCC is disabled and ruled out.** Remaining suspects: (1) R1 is really ~20k, not 2k (a valid setting, 50 mA). This also explains the earlier "complete at 4.15 V": with I_REG 50 mA below the 100 mA cutoff, the charge stops the moment it reaches 4.2 V. (2) PROG2 pin 4 not really High on the board (unsoldered QFN pin; no internal pull), giving a 100 mA USB limit minus the board's ~70 mA. Check: R1 value (meter, power off) and the PROG2 voltage on USB. **Resolved (user): R1 is marked `18C` = 15.0 kΩ (EIA-96), not 2k → I_REG ≈ 67 mA.** This matches the slow charge (slightly above the 25–55 mA estimate, within its uncertainty). It also confirms the early stop: I_TERM 100 mA > I_REG 67 mA. R1 = 15k was the user's own BOM change after drawing the schematic. R2 and R3 are confirmed 10k. Keep R1 = 15k, change R2 to 100k, and update the R1 label on the schematic.

## 2026-10-24: test firmware with a Bluetooth switch (`firmware/MMSA_V2_Recorder_BLE/`)

A copy of Recorder8 (left unchanged) for current-draw testing. REC short press = record (now on release), **hold 1 s = Bluetooth LE on/off** (full stack and radio shutdown, off at boot). Confirmation: 2 flashes of all LEDs = on, 1 long = off, 5 fast = failed. It uses V1's GATT service, so V1's remote page works (a V2 copy is in the folder). BATLOG gets a `ble` column. Built for measuring current per mode.
- **Same session: all 8 mics read flat −30935 (no data on any line), on Recorder8 too.** `MMSA_V2_MicLineShorts`: no shorts, data-line edges 283–395 ns rise / 283 ns fall, identical to the 2026-10-21 **no-flex** reading (with the flex: 1.3–3.3 µs). Cause: the mic flex was unplugged (user). After replugging: all 8 at −47..−53 dBFS, DC within ±300. **The MicLineShorts edge timing is a quick check for whether the flex is connected.**
- **Hardware testing (serial + PC end-to-end with `bleak`), bugs found and fixed:**
  1. Every recording reported 1 pool drop. Picking the file name scanned `MMSA8_0001…` with one ~7 ms `SD.exists()` each (~200–290 ms at 26–43 files), which overflowed the pool *before* recording started, and that read was counted. Fixed: drops count only if recording had started when the discard read began, and the file-number scan runs at card mount (forward only, never back to 1, per V1's overwrite lesson). REC now opens the file in ~75 ms.
  2. One DMA overflow on the **first** Bluetooth switch-on after boot (full RF calibration). Fixed with a warm-up at boot, before the PDM clock starts.
  3. **Panic "Stack canary watchpoint triggered (ipc0)"**, about 1 in 20 switch-ons, mostly seen during recordings. Decoded backtrace: `btdm_intr_alloc` → `esp_intr_alloc` → `heap_caps_malloc` running in ESP-IDF's core-0 IPC task (1 KB stack, fixed in the prebuilt Arduino libs), with an interrupt landing on top. The controller always allocates its interrupts through IPC, whichever core calls it, so moving the BLE task to core 0 didn't help. Fixed with `-Wl,--wrap=esp_bt_controller_init/deinit`: the controller is initialised once (in the boot warm-up) and only disabled/enabled after that. 0 crashes in ~320 switches since. The build needs those link flags (in the firmware README); without them the firmware refuses to switch Bluetooth on.
  4. The BLE library never frees a service (private destructor): ~850 bytes leaked per cycle. Fixed by deleting it (`#define private public` around the BLE includes only); now ~24 bytes per cycle.
  5. If the card wasn't mounted at boot, the pool was sized without the card's ~30 KB, and a later mount ate the Bluetooth reserve. Fixed (the pool reserves the mount).
- **RAM now:** pool 9 blocks (~192 ms); the controller keeps ~35 KB from boot; Bluetooth on takes ~40 KB more; Bluetooth refuses to start below 60 KB free.
- **Open:** (a) **SD card slowdowns, not Bluetooth:** 3–5 s stretches where the card can't sustain 768 KB/s, losing 0.7–1.3 s of audio. 3 in ~550 s with Bluetooth on or switching, and 1 in 726 s with it off (the 2 × 270 s control). That's the long-recording SD limit the earlier to-do list wanted to find; no buffer short of PSRAM covers it. (b) After a reset within seconds of a recording, the card can refuse to mount for ~8–12 s (V1's wake-up clocks didn't cure it); a power cycle avoids it.
- User confirmed the 1 s REC hold and the Bluetooth LED flashes work.
- **PSRAM buffer verified (2026-10-24).** Same firmware built with `PSRAM=opi`: 4 MB pool in PSRAM (~5.5 s), REC button disabled while it's on IO35 (the firmware never touches IO35 when PSRAM is on). 3 × 300 s recordings (Bluetooth off / on / switching): **0 audio lost**; two SD slowdowns absorbed (peak backlog 1.02 s and 0.90 s, drained in 4–6 s); deepest use 48/256 blocks. SD average 1.47–1.50 MB/s via SPI at 20 MHz (2× the 768 KB/s need; the card's 10 MB/s rating is for native SD mode). **Bodge chosen: REC button from pad 28 (IO35) to pad 23 (IO21)**, then `BUTTON_PIN 21` + `PSRAM=opi`. Cause of the slowdowns still to pin down: likely card housekeeping provoked by FatFs FAT updates. Next: time writes inside a slowdown, and try `f_expand` pre-allocation.
- **REC bodge done and verified (2026-10-24):** button moved from pad 28 (IO35) to pad 23 (IO21). Boot reads IO21 HIGH (released); the `p` check counted 27 REC presses during 577 passes over 1 MB of PSRAM with 0 errors, so the button no longer touches the PSRAM. The firmware default is now `BUTTON_PIN 21` + `PSRAM=opi` (5.5 s PSRAM buffer).
- **Boot panic in the warm-up (once, PSRAM build), fixed.** Same `ipc0` stack-canary overflow, in the one remaining controller init. A probe showed those IPC calls come from the controller's own task (`btController`, core 0) for core 0. Third link wrap `esp_ipc_call_blocking`: same-core calls from the Bluetooth tasks run directly on the caller's stack (when > 2 KB free). 5 boots and 10 switches during a recording since: setup ran directly every time, 0 IPC-task calls, no crashes, no audio lost.
- **Board 2 (COM6, MAC 7C:E8:B1:B9:0B:04, not bodged) flashed 2026-10-24** with the unmodified-board build (`PSRAM=disabled`, `-DBUTTON_PIN=35`). Boot OK, IO35 reads released, 9-block internal pool, Bluetooth on/off during a recording OK, 9.9 s recording with no audio lost, SD 1506 KB/s. All 8 mics alive (−48..−50 dBFS), but **mic7 reads ~8 dB above the rest (−40..−42 dBFS)** and mic6 ~2 dB above. Worth a listen or a cover test.
- **Spatial test `MMSA8_0084.wav` (2026-10-24):** a source moved along the array. New `tools/spatial_track.py` → `data/visualizations/MMSA8_0084_spatial.html`. The source was located in 185 of 333 windows (delay misfit 0.09 samples median). It passed over the array from mic0 to mic7 between 4.2 and 11.2 s at **38 mm/s**, **~22 mm from the mic line**, approaching from ~150 mm beyond the mic0 end. Fitted mic pitch **39.5 mm** (276 mm span). Codex's `mic_timeline.py` was also run (`MMSA8_0084_timeline.html`): per-mic peaks march along the array from 4.4 to 11.0 s.
- **Board 2 bodged too (2026-10-24)** and flashed with the default PSRAM build. The first attempt landed the wire on pad 22 (IO14 = SD_CS) by mistake: 0 presses seen, no SD errors, PSRAM clean. After moving it to pad 23: the `p` check counted 11 of the user's 11 presses with 0 PSRAM errors; a recording with a Bluetooth switch lost no audio (SD 1505 KB/s). mic7's earlier +8 dB was not repeated (all mics −48..−50 dBFS), so it was probably the room. **Both boards now run the same firmware: REC on IO21, 5.5 s PSRAM buffer.**
