samam624/esp32-s3-pdm-audio-recorder/070926_Mic_Damping_Paper_Package/03_Tables_and_Source/70926 ESP32 Devkit Test.xlsx

 | lid on | scotch tape | popfilter | popfilter +scotch | popfilter + electrical | CONFOR SQUARE PAD | Confor + scotch | confor + electrical | lid off
background | 1 | 4 | 8 | 11 | 14 | 17 | 20 | 23 | 26
hairdryer (L) | 2 | 5 | 9 | 12 | 15 | 18 | 21 | 24 | 27
Haridryer (H) | 3 | 6 | 10 | 13 | 16 | 19 | 22 | 25 | 28
