samam624/esp32-s3-pdm-audio-recorder/MMSA V2/data/102926/analysis/available_pretest/MMSA8_0001_test_record_timeline.csv

time_s | mic1_rms_dbfs | mic2_rms_dbfs | mic3_rms_dbfs | mic4_rms_dbfs | mic5_rms_dbfs | mic6_rms_dbfs | mic7_rms_dbfs | mic8_rms_dbfs | mic1_peak_dbfs | mic2_peak_dbfs | mic3_peak_dbfs | mic4_peak_dbfs | mic5_peak_dbfs | mic6_peak_dbfs | mic7_peak_dbfs | mic8_peak_dbfs
0.010000 | -57.440 | -58.165 | -58.158 | -57.646 | -57.798 | -57.837 | -57.492 | -58.088 | -47.875 | -49.176 | -49.177 | -49.109 | -49.670 | -50.439 | -48.943 | -50.235
0.030000 | -57.101 | -58.237 | -58.172 | -58.576 | -58.779 | -59.382 | -59.708 | -59.505 | -48.813 | -49.885 | -49.610 | -49.896 | -51.076 | -51.466 | -52.507 | -51.652
0.050000 | -54.158 | -55.272 | -55.203 | -55.387 | -55.359 | -55.750 | -56.100 | -55.717 | -48.207 | -48.297 | -48.246 | -49.007 | -48.899 | -48.828 | -48.546 | -47.292
0.070000 | -51.025 | -52.091 | -52.447 | -52.112 | -52.028 | -51.659 | -52.333 | -52.012 | -44.955 | -46.561 | -45.962 | -45.780 | -45.927 | -45.741 | -45.638 | -44.944
0.090000 | -55.045 | -56.357 | -56.346 | -56.266 | -56.777 | -56.321 | -56.904 | -56.902 | -47.055 | -49.068 | -48.600 | -48.860 | -49.007 | -49.503 | -50.312 | -50.361
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
