samam624/esp32-s3-pdm-audio-recorder/MMSA V2/data/102926/analysis/available_pretest/MMSA8_0002_test_record_in_tunnel_timeline.csv

time_s | mic1_rms_dbfs | mic2_rms_dbfs | mic3_rms_dbfs | mic4_rms_dbfs | mic5_rms_dbfs | mic6_rms_dbfs | mic7_rms_dbfs | mic8_rms_dbfs | mic1_peak_dbfs | mic2_peak_dbfs | mic3_peak_dbfs | mic4_peak_dbfs | mic5_peak_dbfs | mic6_peak_dbfs | mic7_peak_dbfs | mic8_peak_dbfs
0.010000 | -44.698 | -45.912 | -46.257 | -46.352 | -46.667 | -46.765 | -46.965 | -47.097 | -36.115 | -38.189 | -37.983 | -37.891 | -38.275 | -37.966 | -38.170 | -37.621
0.030000 | -46.352 | -47.789 | -48.395 | -48.573 | -49.014 | -49.116 | -49.485 | -49.648 | -39.519 | -40.728 | -40.950 | -41.124 | -40.979 | -41.268 | -40.818 | -40.800
0.050000 | -45.209 | -46.540 | -46.986 | -47.095 | -47.523 | -47.719 | -48.141 | -48.348 | -37.087 | -38.108 | -38.326 | -38.100 | -38.634 | -38.376 | -38.897 | -38.577
0.070000 | -43.830 | -44.669 | -44.608 | -44.239 | -44.193 | -44.091 | -44.242 | -44.549 | -35.976 | -36.683 | -36.476 | -35.884 | -36.074 | -36.072 | -36.252 | -36.620
0.090000 | -43.214 | -44.311 | -44.159 | -43.477 | -43.012 | -42.475 | -42.382 | -42.384 | -34.679 | -35.451 | -35.884 | -36.100 | -36.065 | -35.433 | -35.165 | -34.896
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
