samam624/esp32-s3-pdm-audio-recorder/MMSA V2/data/power/2026-10-24/Power Measurements - Charging (Plugged into USB).csv

;Generated by Scopy-438f138
;Started on Sat Oct 24 14:50:50 2026
Timestamp | Channel_0_DC_RMS | Channel_0_AC_RMS | Channel_1_DC_RMS | Channel_1_AC_RMS
14:50:50 | -0.116 | - | 0.005 | -
14:50:50 | -0.116 | - | 0.005 | -
14:50:50 | -0.116 | - | 0.005 | -
14:50:50 | -0.116 | - | 0.005 | -
14:50:50 | -0.116 | - | 0.005 | -
14:50:50 | -0.116 | - | 0.005 | -
14:50:50 | -0.116 | - | 0.005 | -
14:50:51 | -0.116 | - | 0.005 | -
14:50:51 | -0.116 | - | 0.005 | -
14:50:51 | -0.116 | - | 0.005 | -
14:50:51 | -0.116 | - | 0.005 | -
14:50:51 | -0.116 | - | 0.005 | -
14:50:51 | -0.116 | - | 0.005 | -
14:50:51 | -0.116 | - | 0.005 | -
14:50:51 | -0.116 | - | 0.005 | -
14:50:51 | -0.116 | - | 0.005 | -
14:50:51 | -0.116 | - | 0.005 | -
14:50:52 | -0.116 | - | 0.005 | -
14:50:52 | -0.116 | - | 0.005 | -
14:50:52 | -0.116 | - | 0.005 | -
14:50:52 | -0.116 | - | 0.005 | -
14:50:52 | -0.116 | - | 0.005 | -
14:50:52 | -0.116 | - | 0.005 | -
14:50:52 | -0.116 | - | 0.005 | -
14:50:52 | -0.116 | - | 0.005 | -
14:50:52 | -0.116 | - | 0.005 | -
14:50:52 | -0.116 | - | 0.005 | -
14:50:53 | -0.116 | - | 0.005 | -
14:50:53 | -0.116 | - | 0.005 | -
14:50:53 | -0.116 | - | 0.005 | -
14:50:53 | -0.116 | - | 0.005 | -
14:50:53 | -0.116 | - | 0.005 | -
14:50:53 | -0.116 | - | 0.005 | -
14:50:53 | -0.116 | - | 0.005 | -
14:50:53 | -0.116 | - | 0.005 | -
14:50:53 | -0.116 | - | 0.005 | -
14:50:53 | -0.116 | - | 0.005 | -
14:50:54 | -0.116 | - | 0.005 | -
14:50:54 | -0.116 | - | 0.005 | -
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
14:56:41 | -0.105 | - | 0.005 | -
14:56:41 | -0.105 | - | 0.005 | -
14:56:41 | -0.105 | - | 0.005 | -
14:56:42 | -0.105 | - | 0.005 | -
14:56:42 | -0.105 | - | 0.005 | -
14:56:42 | -0.105 | - | 0.005 | -
14:56:42 | -0.105 | - | 0.005 | -
14:56:42 | -0.105 | - | 0.005 | -
14:56:42 | -0.105 | - | 0.005 | -
14:56:42 | -0.105 | - | 0.005 | -
14:56:42 | -0.105 | - | 0.005 | -
14:56:42 | -0.105 | - | 0.005 | -
14:56:42 | -0.105 | - | 0.005 | -
14:56:43 | -0.105 | - | 0.005 | -
14:56:43 | -0.105 | - | 0.005 | -
14:56:43 | -0.105 | - | 0.005 | -
14:56:43 | -0.105 | - | 0.005 | -
14:56:43 | -0.105 | - | 0.005 | -
14:56:43 | -0.105 | - | 0.005 | -
14:56:43 | -0.105 | - | 0.005 | -
14:56:43 | -0.105 | - | 0.005 | -
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
