samam624/esp32-s3-pdm-audio-recorder/MMSA V2/data/power/2026-10-24/Power Measurements - Idle (Nothing Running).csv

;Generated by Scopy-438f138
;Started on Sat Oct 24 14:42:08 2026
Timestamp | Channel_0_DC_RMS | Channel_0_AC_RMS | Channel_1_DC_RMS | Channel_1_AC_RMS | Portion of Dataset Selected |  | Average Voltage Reading: 0.075290164
14:42:08 | 0.075 | - | 0.005 | - | Timestamp | Channel_0_DC_RMS
14:42:08 | 0.075 | - | 0.005 | - | 14:42:10 | 0.076
14:42:09 | 0.076 | - | 0.005 | - | 14:42:10 | 0.076
14:42:09 | 0.075 | - | 0.005 | - | 14:42:10 | 0.075
14:42:09 | 0.075 | - | 0.005 | - | 14:42:10 | 0.076
14:42:09 | 0.076 | - | 0.005 | - | 14:42:10 | 0.075
14:42:09 | 0.073 | - | 0.005 | - | 14:42:10 | 0.075
14:42:09 | 0.075 | - | 0.005 | - | 14:42:10 | 0.076
14:42:09 | 0.076 | - | 0.005 | - | 14:42:10 | 0.075
14:42:09 | 0.075 | - | 0.005 | - | 14:42:10 | 0.075
14:42:09 | 0.075 | - | 0.005 | - | 14:42:10 | 0.076
14:42:09 | 0.075 | - | 0.005 | - | 14:42:11 | 0.073
14:42:10 | 0.076 | - | 0.005 | - | 14:42:11 | 0.075
14:42:10 | 0.076 | - | 0.005 | - | 14:42:11 | 0.076
14:42:10 | 0.075 | - | 0.005 | - | 14:42:11 | 0.075
14:42:10 | 0.076 | - | 0.005 | - | 14:42:11 | 0.076
14:42:10 | 0.075 | - | 0.005 | - | 14:42:11 | 0.075
14:42:10 | 0.075 | - | 0.005 | - | 14:42:11 | 0.075
14:42:10 | 0.076 | - | 0.003 | - | 14:42:11 | 0.076
14:42:10 | 0.075 | - | 0.005 | - | 14:42:11 | 0.075
14:42:10 | 0.075 | - | 0.005 | - | 14:42:11 | 0.076
14:42:10 | 0.076 | - | 0.005 | - | 14:42:12 | 0.075
14:42:11 | 0.073 | - | 0.005 | - | 14:42:12 | 0.075
14:42:11 | 0.075 | - | 0.003 | - | 14:42:12 | 0.076
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
14:43:19 | 0.078 | - | 0.005 | -
14:43:19 | 0.075 | - | 0.005 | -
14:43:19 | 0.075 | - | 0.005 | -
14:43:19 | 0.076 | - | 0.005 | -
14:43:19 | 0.075 | - | 0.005 | -
14:43:19 | 0.075 | - | 0.005 | -
14:43:20 | 0.076 | - | 0.005 | -
14:43:20 | 0.075 | - | 0.005 | -
14:43:20 | 0.075 | - | 0.005 | -
