samam624/esp32-s3-pdm-audio-recorder/MMSA V2/data/power/2026-10-24/Power Measurements - Preliminary Test.csv

;Generated by Scopy-438f138
;Started on Sat Oct 24 14:31:35 2026 |  |  |  |  | Average | 0.073766667
Timestamp | Channel_0_DC_RMS | Channel_0_AC_RMS | Channel_1_DC_RMS | Channel_1_AC_RMS | 14:32:00 | 0.073
14:31:35 | 0.073 | - | 0.002 | - | 14:32:00 | 0.073
14:31:35 | 0.073 | - | 0.003 | - | 14:32:00 | 0.073
14:31:35 | 0.075 | - | 0.003 | - | 14:32:00 | 0.075
14:31:35 | 0.071 | - | 0.003 | - | 14:32:00 | 0.075
14:31:35 | 0.073 | - | 0.003 | - | 14:32:00 | 0.073
14:31:36 | 0.073 | - | 0.003 | - | 14:32:00 | 0.075
14:31:36 | 0.073 | - | 0.003 | - | 14:32:00 | 0.075
14:31:36 | 0.073 | - | 0.003 | - | 14:32:00 | 0.073
14:31:36 | 0.075 | - | 0.003 | - | 14:32:00 | 0.073
14:31:36 | 0.075 | - | 0.003 | - | 14:32:01 | 0.075
14:31:36 | 0.073 | - | 0.003 | - | 14:32:01 | 0.073
14:31:36 | 0.073 | - | 0.003 | - | 14:32:01 | 0.073
14:31:36 | 0.075 | - | 0.003 | - | 14:32:01 | 0.075
14:31:36 | 0.073 | - | 0.003 | - | 14:32:01 | 0.071
14:31:36 | 0.073 | - | 0.003 | - | 14:32:01 | 0.073
14:31:37 | 0.075 | - | 0.003 | - | 14:32:01 | 0.073
14:31:37 | 0.071 | - | 0.003 | - | 14:32:01 | 0.073
14:31:37 | 0.073 | - | 0.003 | - | 14:32:01 | 0.073
14:31:37 | 0.075 | - | 0.003 | - | 14:32:01 | 0.073
14:31:37 | 0.071 | - | 0.003 | - | 14:32:02 | 0.075
14:31:37 | 0.075 | - | 0.003 | - | 14:32:02 | 0.075
14:31:37 | 0.073 | - | 0.003 | - | 14:32:02 | 0.075
14:31:37 | 0.073 | - | 0.003 | - | 14:32:02 | 0.075
14:31:37 | 0.073 | - | 0.003 | - | 14:32:02 | 0.075
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
14:34:11 | 0.075 | - | 0.003 | -
14:34:11 | 0.075 | - | 0.003 | -
14:34:11 | 0.073 | - | 0.003 | -
14:34:11 | 0.075 | - | 0.003 | -
14:34:11 | 0.075 | - | 0.003 | -
14:34:12 | 0.073 | - | 0.003 | -
14:34:12 | 0.075 | - | 0.003 | -
14:34:12 | 0.075 | - | 0.003 | -
14:34:12 | 0.075 | - | 0.003 | -
