samam624/esp32-s3-pdm-audio-recorder/MMSA V2/data/power/2026-10-24/Power Measurements - Recording Only (No SD or BL).csv

;Generated by Scopy-438f138
;Started on Sat Oct 24 15:02:22 2026
Timestamp | Channel_0_DC_RMS | Channel_0_AC_RMS | Channel_1_DC_RMS | Channel_1_AC_RMS | Charging Battery |  | Baseline |  | Baseline + Mics |  | Baseline + Mics + BL |  | Baseling + Bl |  | Baseline |  | Test | Average Voltage (V)
15:02:22 | -0.098 | - | 0.006 | - | Average Voltage | -0.097644357 | Average Voltage | 0.079475806 | Average Voltage | 0.117922053 | Average Voltage | 0.141064825 | Average Voltage | 0.10285443 | Average Voltage | 0.079797101 | Charging Battery | -0.097644357
15:02:22 | -0.098 | - | 0.006 | - | Timestamp | Channel_0_DC_RMS | Timestamp | Channel_0_DC_RMS | Timestamp | Channel_0_DC_RMS | Timestamp | Channel_0_DC_RMS | Timestamp | Channel_0_DC_RMS | Timestamp | Channel_0_DC_RMS | Baseline | 0.079475806
15:02:22 | -0.098 | - | 0.006 | - | 15:02:22 | -0.098 | 15:03:38 | 0.111 | 15:03:50 | 0.127 | 15:04:43 | 0.146 | 15:06:17 | 0.098 | 15:06:33 | 0.081 | Baseline + Mics | 0.117922053
15:02:22 | -0.098 | - | 0.006 | - | 15:02:22 | -0.098 | 15:03:38 | 0.079 | 15:03:50 | 0.114 | 15:04:43 | 0.14 | 15:06:17 | 0.105 | 15:06:33 | 0.076 | Baseline + Mics + BL | 0.141064825
15:02:22 | -0.098 | - | 0.006 | - | 15:02:22 | -0.098 | 15:03:38 | 0.081 | 15:03:51 | 0.121 | 15:04:43 | 0.135 | 15:06:17 | 0.102 | 15:06:33 | 0.087 | Baseline + Bl | 0.10285443
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
15:02:30 | -0.098 | - | 0.005 | - | 15:02:30 | -0.098 | 15:03:46 | 0.079 | 15:03:59 | 0.117 | 15:04:51 | 0.148 | 15:06:25 | 0.102 | 15:06:41 | 0.078
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
