samam624/esp32-s3-pdm-audio-recorder/MMSA V2/cad/airfoil_testbed_4415/output/reference/testbed_ports.png

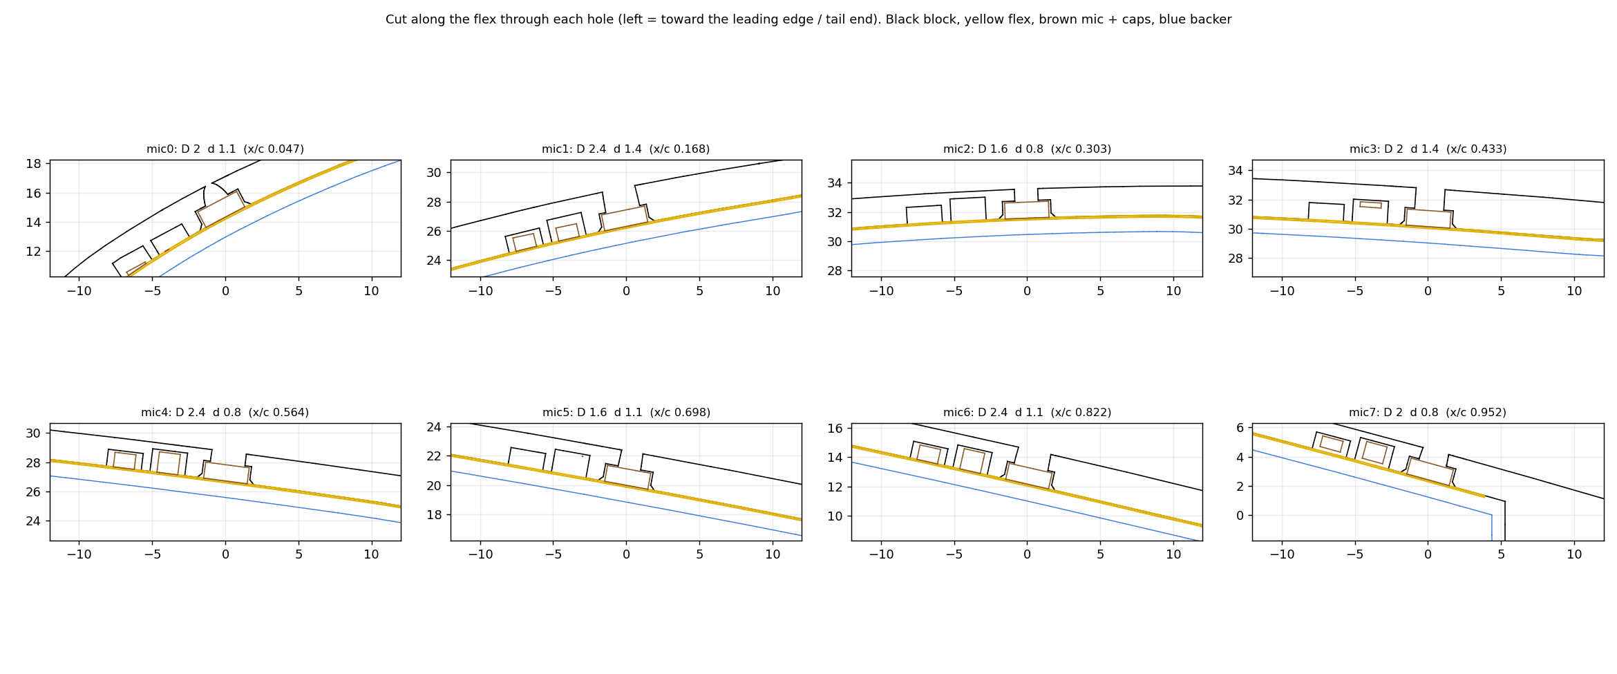
MMSA V2/cad/airfoil_testbed_4415/output/reference/testbed_ports.png
