samam624/esp32-s3-pdm-audio-recorder/(commit log)

2026-07-07 Initial commit: ESP32-S3 PDM mic SD recorder with BLE control
    Working SD-card audio recorder with button/BLE start-stop triggering,
    plus the earlier USB-mic and SD-diagnostic sketches kept for reference.
2026-07-09 Add BLE status telemetry, storage/data-flow warnings, and SD reliability fixes
    Extend the BLE status characteristic from a 1-byte recording flag to a
    10-byte payload (recording/SD-ready/low-space/error flags, live byte
    counter, free space, latched error code) with a 500ms heartbeat, so
    ble_control.html can confirm a recording is actually producing data on
    the card instead of just trusting the button state. The remote now
    shows live audio-saved/free-space stats and surfaces stale-link,
    data-stall, device-error, and disconnect-mid-recording warnings.
    Also fixes three reliability issues found while bench testing:
    - WAV header is rewritten in place every flush interval instead of only
    at stop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
2026-09-27 Add editable ESP32 recorder presentation draft
2026-10-02 Sync laptop work: fix sped-up recordings from slow SD mounts
    Brings in the firmware and recordings pushed from the laptop to
    samam624/ESP32_devkit_test (commits c906014 and 2b0db43), which were
    built on top of 34f4dca.
    Firmware (ESP32_S3_SD_Recorder):
    - Re-sweep the SD mount after a hot-insert until it reaches full SPI
    speed; a card probed mid-insertion could settle at 4 MHz, too slow to
    keep up with the audio, which dropped samples (sped-up playback)
    - Queue BLE start/stop commands to loop() instead of running them on
    the BLE task, which could close the file mid-write on the other core
    - Per-recording diagnostics: dropped bytes, I2S DMA overflows, SD write
    timing, min free buffers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
2026-10-02 Add full-spectrum wind attenuation analysis and refresh damping figures
    full_spectrum_attenuation.py integrates each configuration's Welch PSD
    over 20 Hz-20 kHz and compares it with the lid-off take, writing
    full_spectrum_attenuation.csv and figure 08. Figures 01-07 and the
    summary image are regenerated.
2026-10-26 Add real netlist, datasheets, battery smoothing and 6.5 h run-down
    - Recorder BLE firmware and remote page: live levels, clipping alert,
    calibration check, battery meter, soak results (earlier 2026-10-25 work).
    The battery voltage sent to the remote is now averaged over ~16 s
    (compiled, not yet flashed). The page averages it again over ~8 s, shows
    it in 10 mV steps and keeps the low warning up until 3.60 V, so it no
    longer flickers.
    - reference: Altium netlist and both BOMs, 17 datasheets with text copies.
    Component index and pin/net reference rebuilt from the netlist, with the
    board rework recorded (REC on IO21, 1V8 shorted to 3V3, SD breakout,
    charger resistors, Wurth FPC).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
2026-10-26 Add 2026-10-26 charge log and plot
    Full charge of board 2's 1200 mAh cell straight after the run-down: 3.50 V to
    charger stop at 4.10 V (board reading) in 2.58 h, two short top-ups, then rests
    at ~4.01 V. Adds tools/plot_batlog_charge.py to plot a charge run.
2026-10-26 Add battery run-down and charge plots to the 2026-10-25 team update
    Copies the two batlog plots into the team update folder and removes its README.
2026-10-28 Add hardware photos, PCB views, and selected results to README
2026-10-29 Add recording names to the MMSA V2 remote page and firmware
    The remote page has a "Recording name" box. The board puts the name after
    the take number (/MMSA8_0086_wing_15ms/MMSA8_0086_wing_15ms_01.wav), so
    takes stay unique and in order. The name is cleaned (letters, digits and
    '-' kept, other runs become '_', 32 chars max), stays set for later takes
    (REC button too) until changed, and is cleared by a reset. The page sends
    it on connect and before each start, and shows the folder the next take
    will get. New characteristic 6e400007 (read/write/notify); older firmware
    just records numbered takes.
    verify_card.py and stress_test.py accept named take folders. The page
    also keeps tall content scr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
2026-10-29 Add deep sleep to the MMSA V2 recorder (hold BOOT 2 s)
    Idle draws ~70-80 mA. Holding BOOT for 2 s (or serial 'z') now finishes
    any recording, sends the remote a final status with a new "going to
    sleep" flag (0x40), switches Bluetooth off, unmounts the SD card (CS held
    high), holds the mic clock low so the mics power down, and enters deep
    sleep. REC or BOOT wakes it into idle (RES too); the waking REC press
    doesn't start a recording. The take name (now in RTC memory), the clock
    and the Bluetooth on/off state survive sleep. BATLOG gets a "# sleep"
    line.
    The remote page shows "the board went to sleep" on that disconnect
    instead of the dropped-mid-recording warning.
    Flashed to boards 1 and 2.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
2026-10-30 Update charger component documentation
2026-11-03 Tidy repo layout: legacy firmware and damping study in their own folders
    - Earlier V1 sketches and test files move to legacy/.
    - The 2026-07-09 damping study (070926 Data, damping_tests, paper package)
    merges into damping_2026-07-09/.
    - Team-update images are replaced by the copies under data/batlog,
    data/power and data/visualizations; duplicate waveform images removed.
    - README, bringup notes and the deck builder point at the new paths.
2026-11-03 Add 2026-10-29 wind tunnel test: notes, analysis, tools and deck
    - data/102926: test notes, analysis CSVs/plots and photos (WAVs stay
    local, per .gitignore).
    - Analysis and presentation tools for the floor and wing runs.
    - wav_band_levels / wav_continuity_corr / wav_noise_floor now cover all
    channels instead of stopping at 6.
    - Presentation deck with the wind tunnel analysis (PPTX + PDF).
2026-11-03 Add port/filter plan and flex geometry notes
    - PORT_FILTER_PLAN.md with the port model, plots and the Ozcakmak 2019
    reference paper (open access, Wind Energy Science).
    - MIC_FLEX_MODULE.md: JLC flex build (0.11 mm), strip/tail geometry,
    port positions and cap heights from the flex STEP.
    - COMPONENT_INDEX.md: IMP34DT05 is top-port.
2026-11-03 Add airfoil port test beds and the printed NACA 4415 wing
    - cad/airfoil_testbed: v1 port test bed (NACA 0012, superseded).
    - cad/airfoil_testbed_4415: port test bed on the 4415 wing surface,
    8 port sizes, flex at 36.5 deg, one P1S plate (76 g, 3 h 16).
    - cad/wing_4415: full wing in two P1S halves split at the chord line,
    with the flex at 28 deg, the MMSA V2 board and the 2000 mAh battery
    inside. mic0 unpopulated so its strip is the cable. Board dimensions
    and port size are still estimates (see README).
2026-11-03 Label the old port test bed as NACA 0012
    cad/airfoil_testbed -> cad/airfoil_testbed_0012, and its MMSA_testbed_v1
    files become MMSA_testbed_0012, so it can't be mistaken for the current
    NACA 4415 rig. Links, imports and notes updated to match.
